Proto-Plastik/ULTIMATE/README.md

# Printers
Repository for Proto-Plastik ULTIMATE 3D printer.
This repository includes STL and STEP files.

Please refer to the PDF in this repository for detailed assembly drawings.
