Proto-Plastik/ULTIMATE/Power Supply Mount/A51Z Classic CLUB.xls

ITEM NO. | PART NUMBER | DESCRIPTION | QTY.
1 | A51Z Frame |  | 1
 | A5 Frame Drive Housing 1Z Z-Axis |  | 1
 | B18.3.1M - 3 x 0.5 x 12 Hex SHCS -- 12NHX |  | 12
 | B18.3.1M - 3 x 0.5 x 8 Hex SHCS -- 8NHX | SHCS M3x8 | 4
 | B18.3.1M - 3 x 0.5 x 16 Hex SHCS -- 16NHX |  | 2
 | B18.3.1M - 3 x 0.5 x 5 Hex SHCS -- 5NHX |  | 4
 | B18.3.1M - 8 x 1.25 x 25 Hex SHCS -- 25NHX |  | 1
 | 1Z z-axis drive housing-body |  | 1
 | 1Z z-axis-drive housing-cover |  | 1
 | GT2_Pulley |  | 1
 | OpenBuilds Nema 17 SKU775 | NEMA17 Stepper Motor | 1
 | A5 Bearing Assy Y- Axis | Bearing assembly for y-axis linear rods | 1
 | bearing cover and tray |  | 1
 | LM8LUU Bearing |  | 1
 | rigid coupler |  | 1
 | RAMPS Mount-front |  | 1
 | RAMPS Mount-rear |  | 1
 | RAMPS1_4 |  | 1
 | RAMPS1_4 |  | 1
 | User Library-POWER MOSFET, NON- SURFACE-MOUNT |  | 3
 | female_header_a- bl254-dg-g08d |  | 1
 | female_header_a- bl254-eg-g08d |  | 10
 | pin_header_aw254-dg -g36d |  | 1
 | pin_header_aw140-eg -g18d |  | 1
 | pin_header_aw140-eg -g08d |  | 5
 | pin_header_aw140-eg -g06d |  | 5
 | pin_header_aw140-eg -g04d |  | 6
 | pin_header_aw254-dg -g06d |  | 5
 | pin_header_aw254-dg -g08d |  | 3
 | pin_header_aw254-dg -g10d |  | 1
 | terminal_blocks_a- tb500-to06 |  | 1
 | terminal_blocks_a- tb508-oq04ch |  | 1
 | pin_header_aw140-eg -g02d |  | 1
 | pin_header_aw140-eg -g03d |  | 1
 | ARDUINO_MEGA |  | 1
 | ARDUINO_MEGA_BRD |  | 1
 | pin_header_aw140- eg-g02d |  | 3
 | User Library- Arduino Mega_DC POWER JACK |  | 1
 | User Library- Arduino Mega_USB SM host |  | 1
 | User Library- Arduino Mega_Atmega1280 (WGL) |  | 1
 | User Library- Arduino Mega_tactile BUTTON |  | 1
 | User Library- Arduino Mega_SM LED |  | 1
 | User Library- Arduino Mega_PIN HEADER FEMALE 2X18SLDPRT |  | 1
 | User Library- Arduino Mega_PIN HEADER FEMALE 6 |  | 1
 | User Library- Arduino Mega_PIN HEADER FEMALE 8 |  | 5
 | pin_header_aw254- dg-g06d |  | 1
 | User Library- CAPSMD6_3x3_9 |  | 6
 | User Library- CAPSMD6_3x3_9_CAP 003 |  | 1
 | User Library- CAPSMD6_3x3_9_CAP |  | 1
 | User Library- CAPSMD6_3x3_9_CAP 001 |  | 1
 | User Library- CAPSMD6_3x3_9_CAP 002 |  | 1
 | User Library- CAPSMD6_3x3_9_CAP 004 |  | 1
 | User Library- CAPSMD4x3_9 |  | 3
 | User Library- CAPSMD4x3_9_CAPSM D4x3_9003 |  | 1
 | User Library- CAPSMD4x3_9_CAPSM D4x3_9004 |  | 1
 | User Library- CAPSMD4x3_9_CAPSM D4x3_9002 |  | 1
 | User Library- CAPSMD4x3_9_CAPSM D4x3_9001 |  | 1
 | User Library- CAPSMD4x3_9_CAPSM D4x3_9 |  | 1
 | User Library- APA3010GCCK_GREE N |  | 1
 | User Library- APA3010GCCK_RED |  | 3
 | User Library-MF- R1100___ _________ |  | 1
 | User Library-MF- R500___ _________ |  | 1
 | User Library- SWITCH, TACTILE, RIGHT ANGLE, 12VDC, 50MA, 6_85MM ACTUATOR, WEALTH METAL TC-0244Z |  | 1
 | mounting foot TPE |  | 2
 | A5 Frame Chassis Center |  | 1
 | chassis |  | 1
 | 5mm ID x 8mm OD x 6mm Flanged |  | 2
 | R6RS bearing | - | 2
 | SBHCSCREW 0.3125- 18x1-HX-N |  | 2
 | GT2 Drive Pulley |  | 1
 | driveshaft |  | 1
 | B18.3.1M - 3 x 0.5 x 8 Hex SHCS -- 8NHX | SHCS M3x8 | 4
 | Part2^A5 Frame Chassis Center |  | 1
 | A5 Frame Drive Housing 1Z Y-Axis |  | 1
 | 1Z y-axis-drive housing-body |  | 1
 | A5 Bearing Assy Y- Axis | Bearing assembly for y-axis linear rods | 1
 | bearing cover and tray |  | 1
 | LM8LUU Bearing |  | 1
 | OpenBuilds Nema 17 SKU775 | NEMA17 Stepper Motor | 1
 | 1Z y-axis-drive housing-cover |  | 1
 | mounting foot TPE |  | 2
 | B18.3.1M - 3 x 0.5 x 12 Hex SHCS -- 12NHX |  | 12
 | B18.3.1M - 3 x 0.5 x 5 Hex SHCS -- 5NHX |  | 4
 | base gusset |  | 2
 | B18.3.1M - 3 x 0.5 x 16 Hex SHCS -- 16NHX |  | 4
 | B18.3.1M - 3 x 0.5 x 10 Hex SHCS -- 10NHX |  | 8
 | RDOM8 8mm rod | 8mm rod with 4mm threads in each end | 2
 | .375-12 x 12 Leadscrew |  | 1
2 | A51Z X-Axis Gantry |  | 1
 | A51Z X-Axis Gantry- left |  | 1
 | A51Z X-Gantry Left |  | 1
 | acme threaded retainer |  | 1
 | B18.3.1M - 3 x 0.5 x 16 Hex SHCS -- 16NHX |  | 6
 | B18.2.4.1M - Hex nut, Style 1, M3 x 0.5 --D-N |  | 2
 | A51Z X-Gantry Left- retainer |  | 1
 | B18.3.1M - 3 x 0.5 x 12 Hex SHCS -- 12NHX |  | 2
 | OpenBuilds Nema 17 SKU775 | NEMA17 Stepper Motor | 1
 | ProtoPlastik X-gantry spacer |  | 2
 | GT2 Drive Pulley |  | 1
 | LM8LUU Bearing |  | 1
 | A51Z X-Gantry-snap plug |  | 2
 | A51Z X-Axis Gantry- right |  | 1
 | LM8LUU Bearing |  | 1
 | A51Z X-Gantry Left- retainer |  | 1
 | B18.3.1M - 3 x 0.5 x 12 Hex SHCS -- 12NHX |  | 2
 | ProtoPlastik X-gantry spacer |  | 2
 | R6RS bearing | - | 2
 | A51Z X-Gantry Right |  | 1
 | A51Z X-Gantry Right- axle |  | 1
 | ProtoPlastik X-gantry RIGHT-cap |  | 1
 | A51Z X-Gantry Right- tensioner |  | 1
 | A51Z X-Gantry Right- tightening knob | Tightening Knob | 1
 | A51Z X-Gantry Right- lock nut | Locking Nut | 1
 | A51Z X-Gantry-snap plug |  | 2
 | RDOM8 8mm rod |  | 2
 | x-drive belt |  | 1
 | Filament Drive |  | 1
 | OpenBuilds Nema 17 SKU775 | NEMA17 Stepper Motor | 1
 | MK7 | MK7 Filament Drive Gear | 1
 | e3D Lite6 | e3D Lite6 1.75 | 1
 | parte_sotto_lite6 |  | 1
 | corpo_lite6 |  | 1
 | 30x10 fan |  | 1
 | Fan Shroud |  | 1
 | B18.3.4M - 3 x 0.5 x 10 SBHCS --N |  | 2
 | B18.3.1M - 3 x 0.5 x 16 Hex SHCS -- 16NHX |  | 4
 | B18.3.1M - 3 x 0.5 x 35 Hex SHCS -- 18NHX | SHCS M3x35 | 3
 | B18.3.1M - 3 x 0.5 x 16 Hex SHCS -- 16NHX |  | 9
 | B18.3.1M - 3 x 0.5 x 5 Hex SHCS -- 5NHX |  | 1
 | hot end mount- body |  | 1
 | hot end cover | Direct Drive Outer Bracket | 1
 | filament guide access |  | 1
 | motor mount | Motor Mount | 1
 | hot end retainer | Hot End Retainer | 1
 | Filament Drive Tightener | Direct Drive Tightener | 1
 | tensioner | Body | 1
 | 624zz |  | 1
 | B18.3.1M - 3 x 0.5 x 16 Hex SHCS -- 16NHX |  | 1
 | lock nut | Locking Nut | 1
 | tightening knob | Tightening Knob | 1
 | Filament Drive Bearing Holder | Drive Bearing Holder | 1
 | LM8LUU Bearing |  | 2
 | B18.3.1M - 3 x 0.5 x 16 Hex SHCS -- 16NHX |  | 2
 | B18.3.1M - 3 x 0.5 x 12 Hex SHCS -- 12NHX |  | 2
 | bearing holder body | BODY | 1
 | bearing lower retainer | LOWER RETAINER | 1
 | bearing upper retainer | UPPER RETAINER | 1
 | belt retainer | Belt Retainer | 1
 | ptfe tube |  | 1
3 | A51Z Truss |  | 1
 | B18.3.1M - 3 x 0.5 x 20 Hex SHCS -- 20NHX |  | 4
 | B18.3.1M - 3 x 0.5 x 10 Hex SHCS -- 10NHX |  | 6
 | B18.3.1M - 4 x 0.7 x 20 Hex SHCS -- 20NHX |  | 4
 | B18.3.1M - 8 x 1.25 x 30 Hex SHCS -- 30NHX |  | 2
 | B18.3.1M - 4 x 0.7 x 8 Hex SHCS -- 8NHX |  | 1
 | B18.3.1M - 3 x 0.5 x 12 Hex SHCS -- 12NHX |  | 1
 | truss handle bottom |  | 1
 | truss handle top |  | 1
 | truss left |  | 1
 | truss right |  | 1
 | truss right-retainer |  | 1
 | truss left-retainer |  | 1
 | truss center |  | 1
 | GT2_Pulley |  | 2
 | Anti-sag belt |  | 1
 | filament guide |  | 1
4 | A5 Bed |  | 1
 | B18.3.1M - 3 x 0.5 x 16 Hex SHCS -- 16NHX |  | 4
 | B18.3.1M - 3 x 0.5 x 12 Hex SHCS -- 12NHX |  | 4
 | glass clip |  | 4
 | 8 x 8.5 glass |  | 1
 | A5 Bed Build Platform | Modular, printable build platform. | 1
 | build platform-NE |  | 1
 | build platform-NW |  | 1
 | build platform-SE |  | 1
 | build platform-SW |  | 1
 | glass support |  | 2
 | straight spring |  | 4
 | spring cup |  | 8
 | glass support-OH |  | 2
 | B18.22M - Plain washer, 3 mm, narrow |  | 4
 | B18.3.1M - 3 x 0.5 x 35 Hex SHCS -- 18NHX | SHCS M3x35 | 4
 | B18.3.1M - 3 x 0.5 x 25 Hex SHCS -- 18NHX |  | 6
 | B18.3.1M - 3 x 0.5 x 16 Hex SHCS -- 16NHX |  | 4
 | B18.3.1M - 3 x 0.5 x 10 Hex SHCS -- 10NHX |  | 4
 | build platform-clip retainer-OH |  | 2
 | build platform-clip retainer |  | 2
 | A5 Bed Chassis | Modular 3D printable bed chassis | 1
 | bed chassis- spreader |  | 1
 | bed chassis-shaft retainer |  | 4
 | bed chassis- spreader-OH |  | 1
 | bed chassis-belt retainer |  | 2
 | B18.3.1M - 3 x 0.5 x 20 Hex SHCS -- 20NHX |  | 8
 | B18.3.1M - 3 x 0.5 x 12 Hex SHCS -- 12NHX |  | 4
 | RDOM8 8mm rod |  | 2
 | B18.2.4.2M - Hex nut, Style 2, M3 x 0.5 --D-N |  | 8
 | silicon standoff |  | 4
 | heated-bed-glass |  | 1
 | B18.3.1M - 3 x 0.5 x 10 Hex SHCS -- 10NHX |  | 2
5 | B18.3.1M - 3 x 0.5 x 16 Hex SHCS -- 16NHX |  | 11
6 | B18.3.1M - 4 x 0.7 x 12 Hex SHCS -- 12NHX |  | 1
7 | B18.3.1M - 4 x 0.7 x 10 Hex SHCS -- 10NHX |  | 2
