Proto-Plastik/ULTIMATE/2Z X-Axis Bearing Holder - LEFT/STEP/stepper (hardware)-dampener.STEP

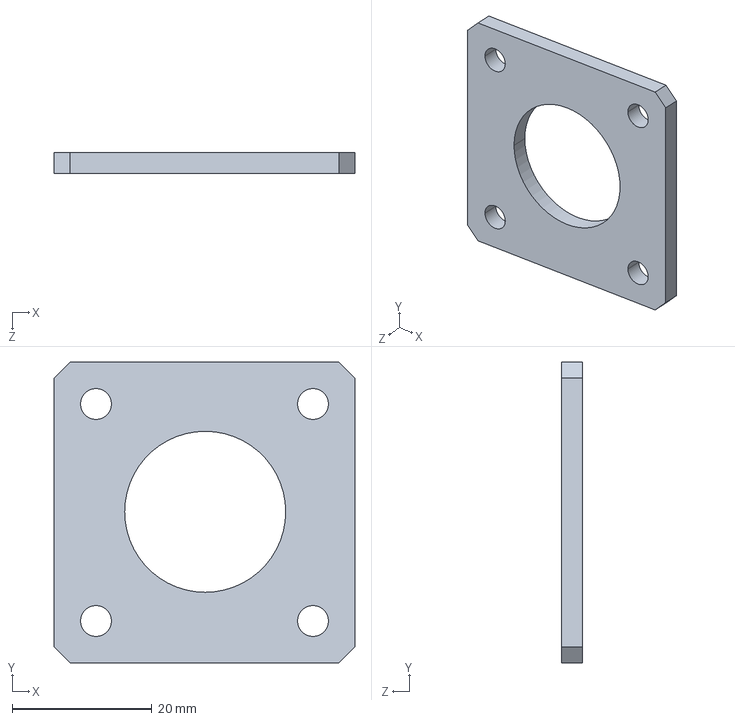
[picture p1: CAD file, 2019-01-01]
2Z X-Axis Bearing Holder - LEFT/STEP/stepper (hardware)-dampener.STEP
43.0 x 43.0 x 3.00 mm
