Proto-Plastik/ULTIMATE/2Z X-Axis Bearing Holder - RIGHT/bearing axle.STL

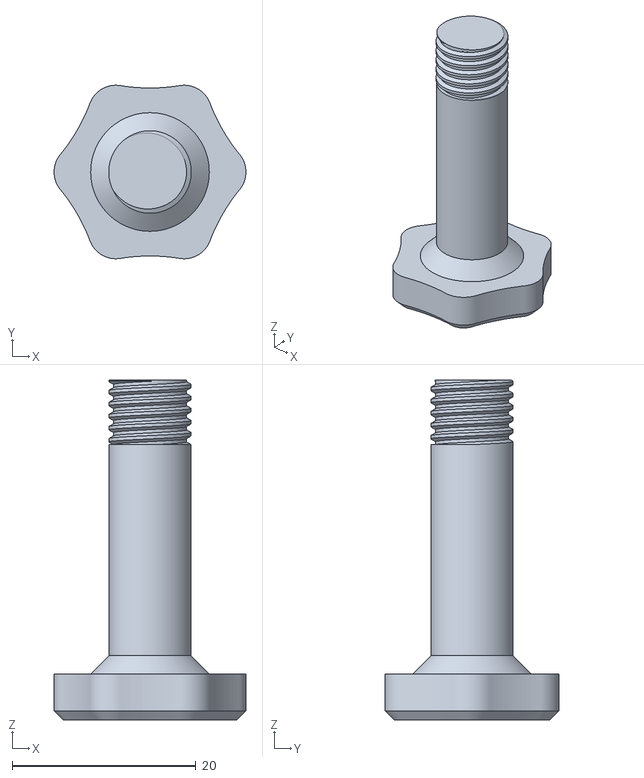
[picture p2: CAD file, 2017-12-21]
2Z X-Axis Bearing Holder - RIGHT/bearing axle.STL
20.9 x 18.9 x 37.0
