Proto-Plastik/ULTIMATE/2Z X-Axis Bearing Holder - RIGHT/STEP/2Z bearing holder right cover.STEP

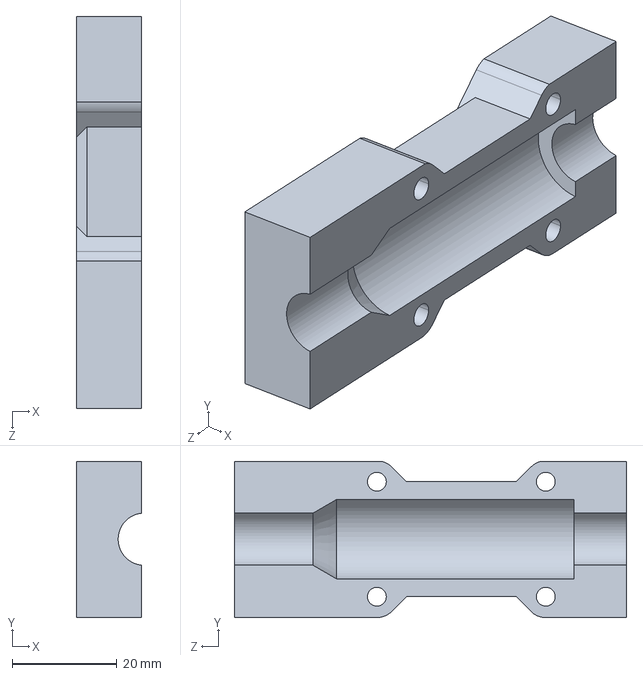
[picture p3: CAD file, 2019-01-01]
2Z X-Axis Bearing Holder - RIGHT/STEP/2Z bearing holder right cover.STEP
12.5 x 29.9 x 75.0 mm
