Proto-Plastik/ULTIMATE/A5 Bed Chassis/STEP/bed chassis-end stop.STEP

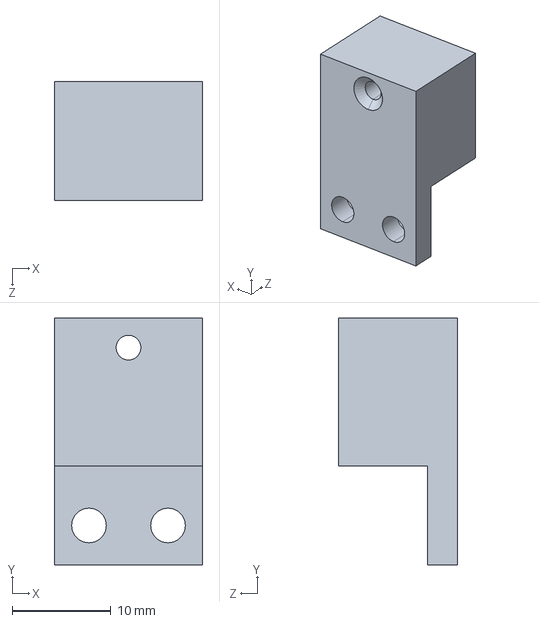
[picture p5: CAD file, 2019-01-01]
A5 Bed Chassis/STEP/bed chassis-end stop.STEP
15.0 x 25.0 x 12.0 mm
