Proto-Plastik/ULTIMATE/A5 Bed/STEP/build platform-clip retainer-OH.STEP

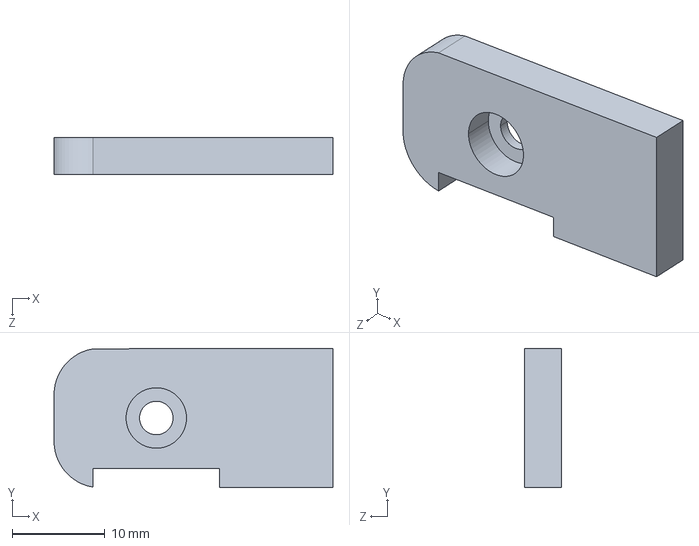
[picture p6: CAD file, 2019-01-01]
A5 Bed/STEP/build platform-clip retainer-OH.STEP
30.0 x 15.0 x 4.00 mm
