Proto-Plastik/ULTIMATE/A5 Frame Chassis Center/STEP/5mm ID x 8mm OD x 6mm Flanged.STEP

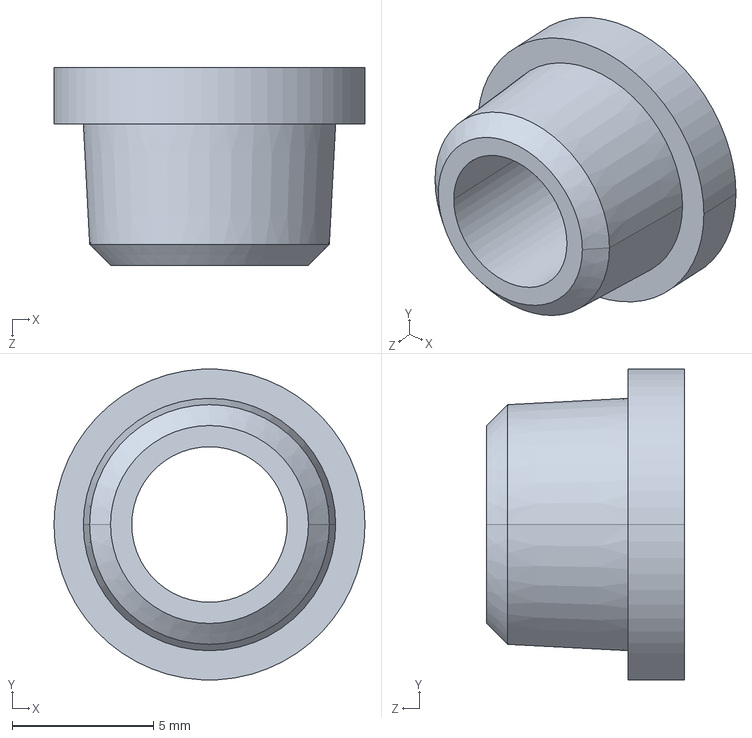
[picture p7: CAD file, 2019-01-01]
A5 Frame Chassis Center/STEP/5mm ID x 8mm OD x 6mm Flanged.STEP
11.0 x 11.0 x 7.00 mm
