Proto-Plastik/ULTIMATE/Controller Enclosure/STEP/display mount-rear cover.STEP

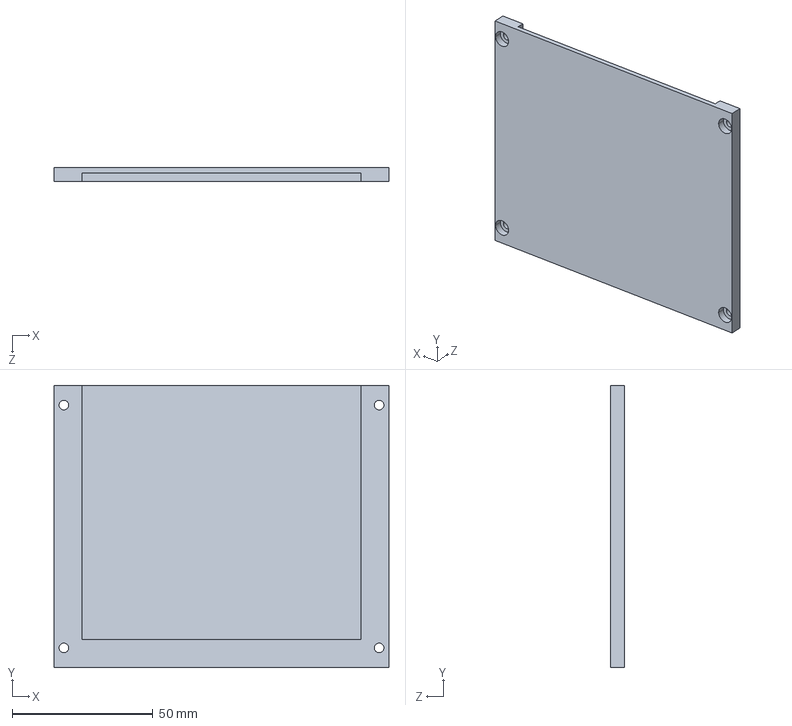
[picture p8: CAD file, 2019-01-01]
Controller Enclosure/STEP/display mount-rear cover.STEP
119.0 x 100.3 x 5.00 mm
