Proto-Plastik/ULTIMATE/Electronics Base/STEP/electronics base.STEP

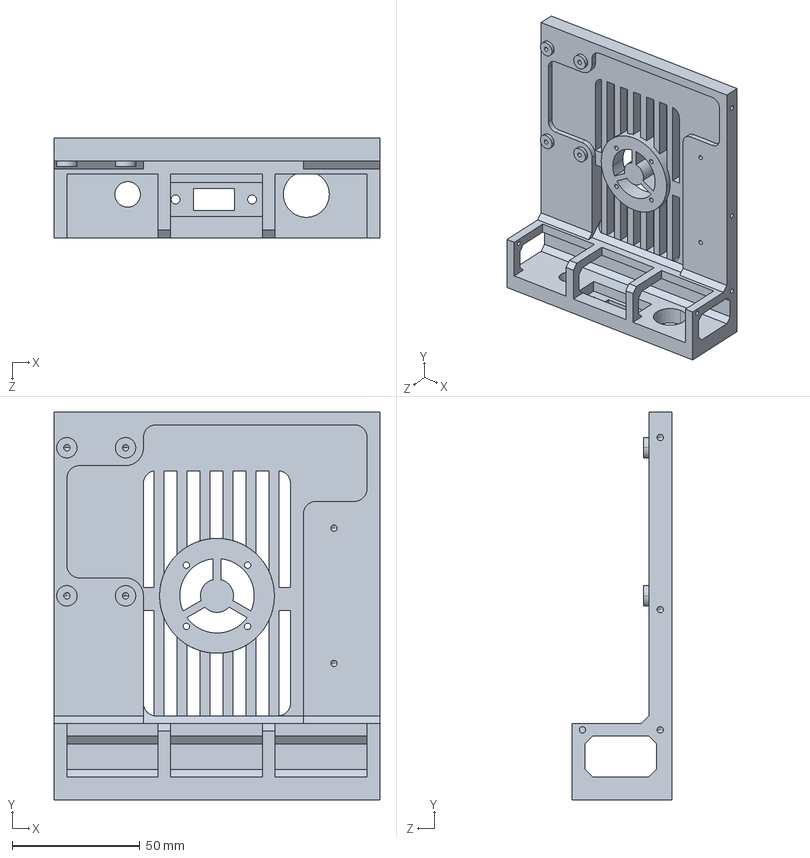
[picture p9: CAD file, 2019-01-01]
Electronics Base/STEP/electronics base.STEP
127.6 x 152.0 x 39.0 mm
