Proto-Plastik/ULTIMATE/Filament Drive Bearing Holder/STEP/bearing upper retainer (LM8LUU).STEP

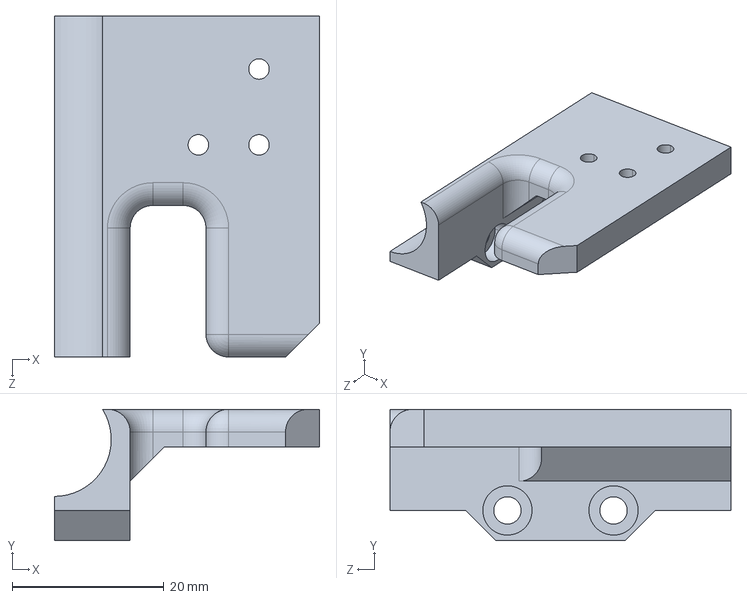
[picture p10: CAD file, 2019-01-01]
Filament Drive Bearing Holder/STEP/bearing upper retainer (LM8LUU).STEP
35.0 x 17.4 x 45.0 mm
