Proto-Plastik/ULTIMATE/Filament Drive Bed Leveling/STEP/Filament Drive BL Touch Mount.STEP

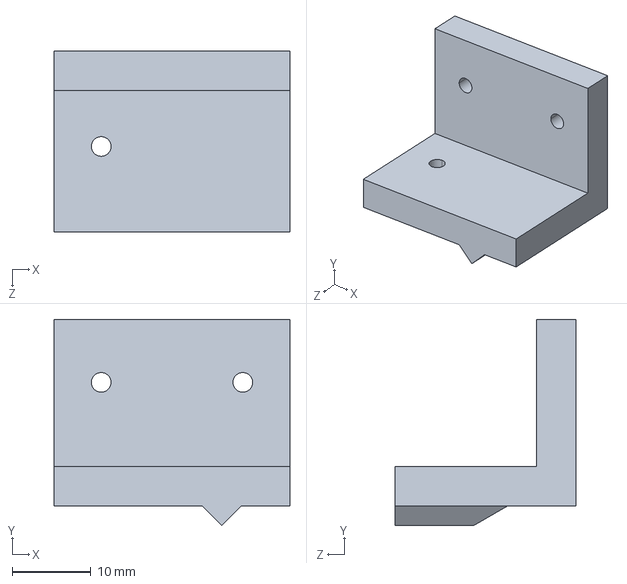
[picture p11: CAD file, 2019-01-01]
Filament Drive Bed Leveling/STEP/Filament Drive BL Touch Mount.STEP
30.0 x 26.2 x 23.0 mm
