Proto-Plastik/ULTIMATE/Filament Drive Cooling Fan/STEP/nozzle bracket.STEP

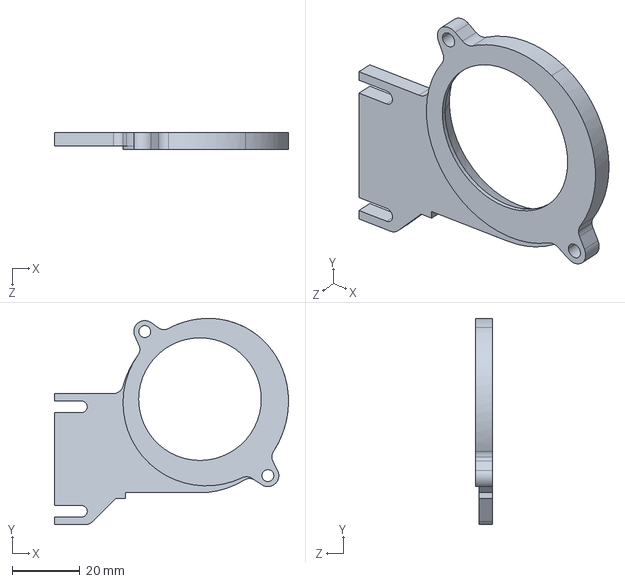
[picture p12: CAD file, 2019-01-01]
Filament Drive Cooling Fan/STEP/nozzle bracket.STEP
69.2 x 61.0 x 5.00 mm
