Proto-Plastik/ULTIMATE/Filament Drive Tightener/STEP/tensioner.STEP

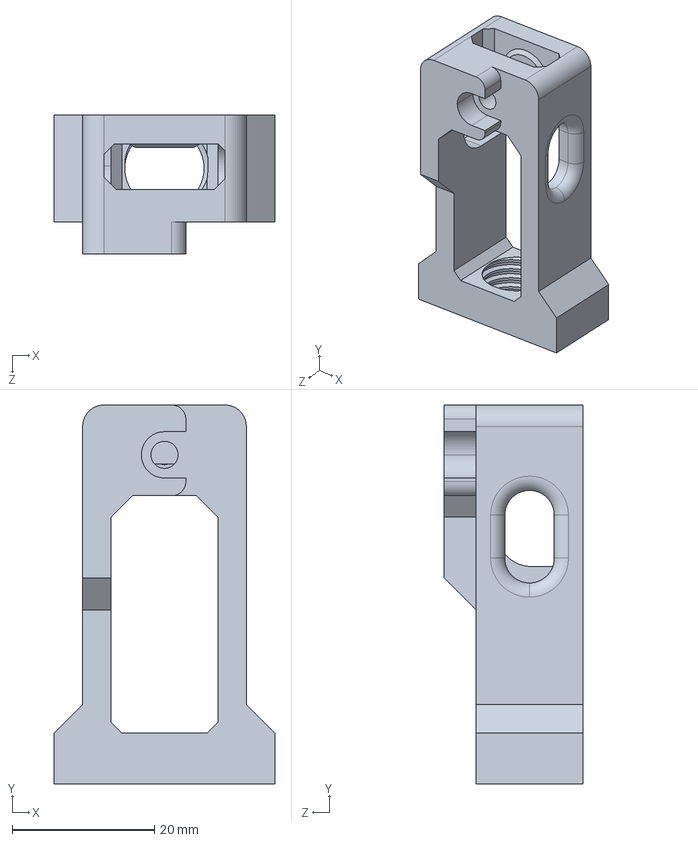
[picture p13: CAD file, 2019-01-01]
Filament Drive Tightener/STEP/tensioner.STEP
31.0 x 53.2 x 19.5 mm
