Proto-Plastik/ULTIMATE/Filament Spool Holder/STEP/filament spool holder spindle-shaft 2Z OH (OH).STEP

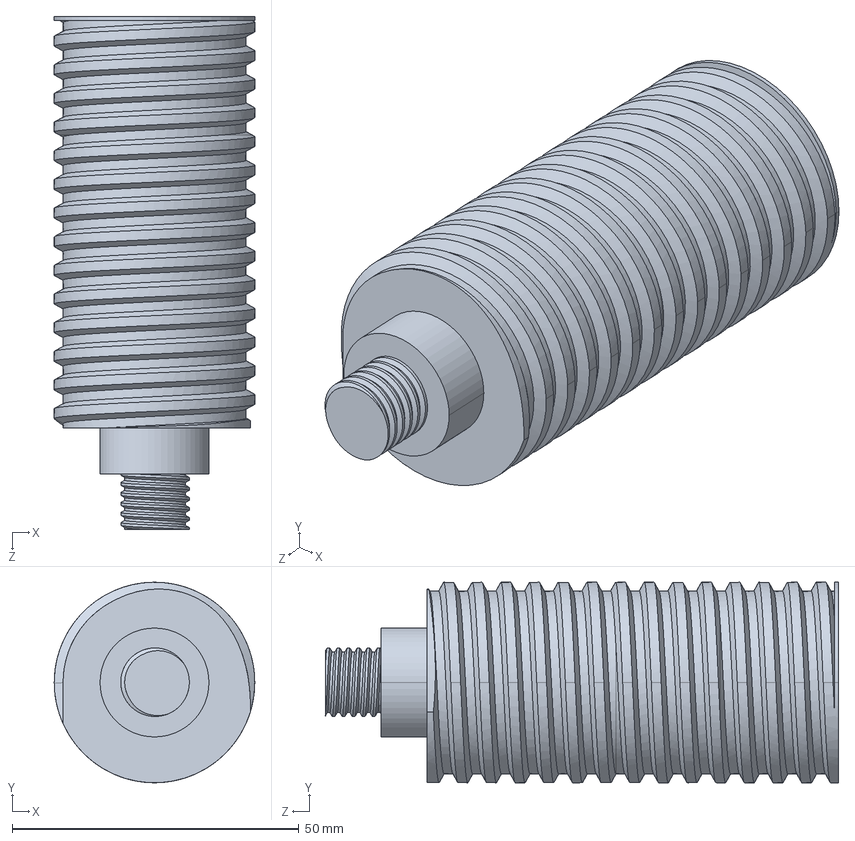
[picture p14: CAD file, 2019-01-01]
Filament Spool Holder/STEP/filament spool holder spindle-shaft 2Z OH (OH).STEP
35.0 x 35.0 x 89.5 mm
