Proto-Plastik/ULTIMATE/Motor Houisng YZ-Axis/STEP/rigid coupler.STEP

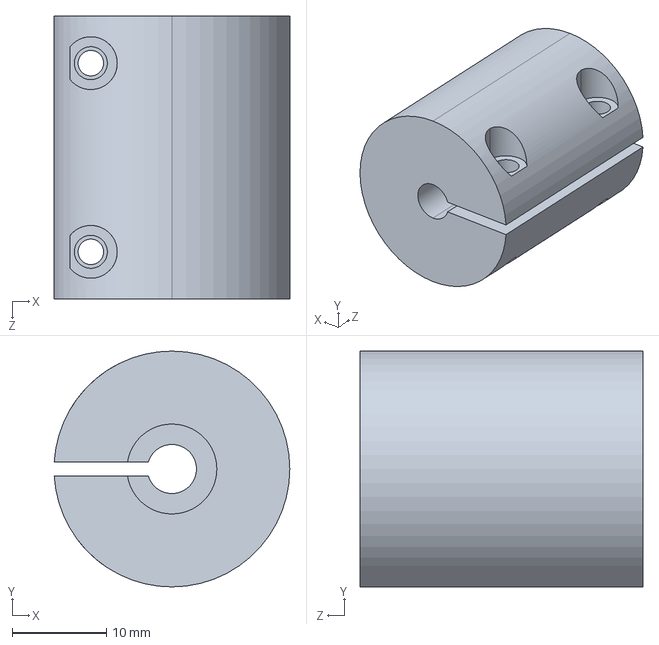
[picture p15: CAD file, 2019-01-01]
Motor Houisng YZ-Axis/STEP/rigid coupler.STEP
25.0 x 25.0 x 30.0 mm
