Proto-Plastik/ULTIMATE/Motor Housing Z-Axis/STEP/motor housing LEFT-Body.STEP

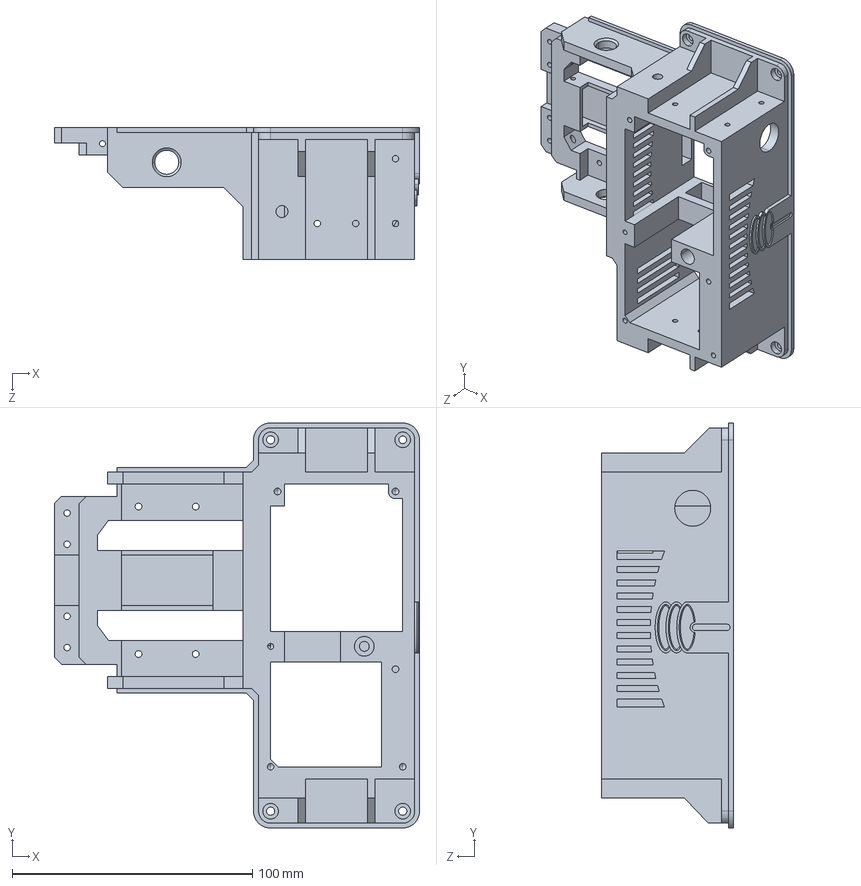
[picture p16: CAD file, 2019-01-01]
Motor Housing Z-Axis/STEP/motor housing LEFT-Body.STEP
152.0 x 168.6 x 55.0 mm
