Proto-Plastik/ULTIMATE/Name Bar/Name Bar-banner.STL

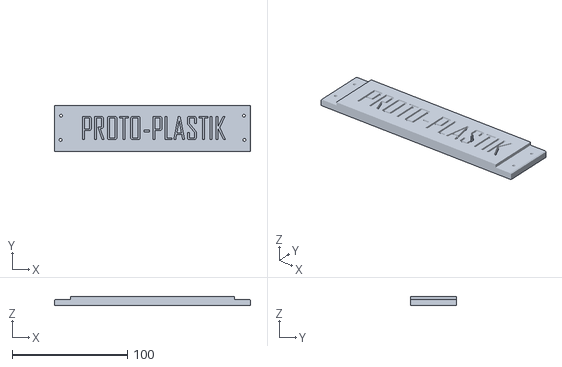
[picture p17: CAD file, 2017-12-31]
Name Bar/Name Bar-banner.STL
170.0 x 40.0 x 7.50
