Proto-Plastik/ULTIMATE/Name Bar/STEP/Name Bar-end.STEP

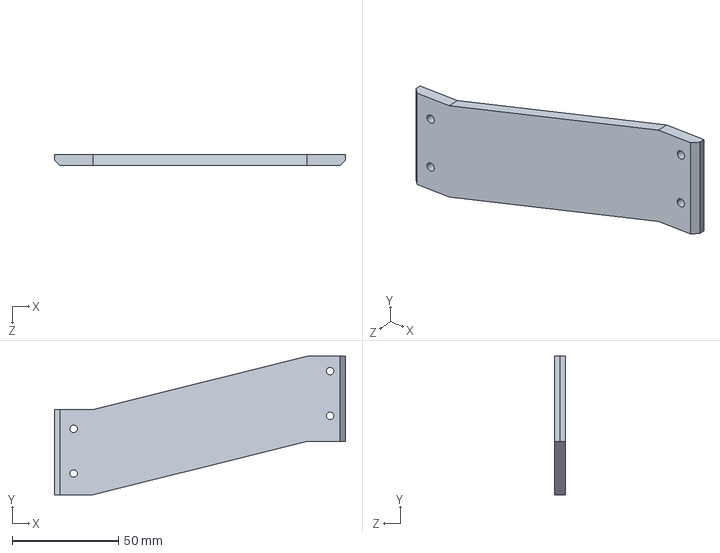
[picture p18: CAD file, 2019-01-01]
Name Bar/STEP/Name Bar-end.STEP
136.7 x 65.1 x 5.00 mm
