Proto-Plastik/ULTIMATE/PI Camera Housing/STEP/PI_CAMERA-cover.STEP

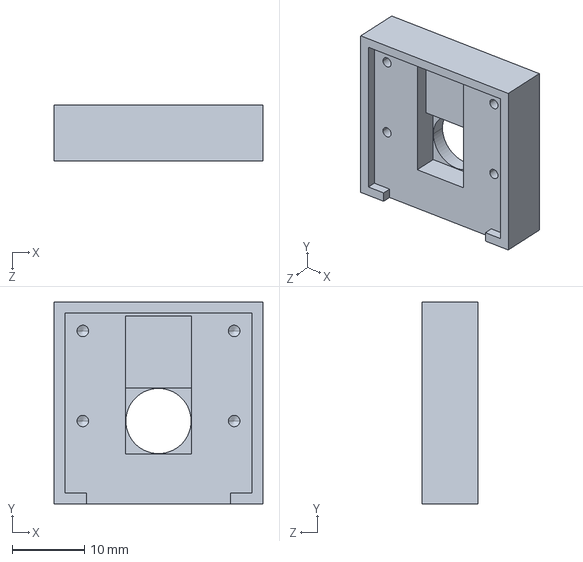
[picture p19: CAD file, 2019-01-01]
PI Camera Housing/STEP/PI_CAMERA-cover.STEP
29.0 x 28.0 x 7.80 mm
