Proto-Plastik/ULTIMATE/Power Supply Mount/STEP/lower cross brace (ULTIMATE).STEP

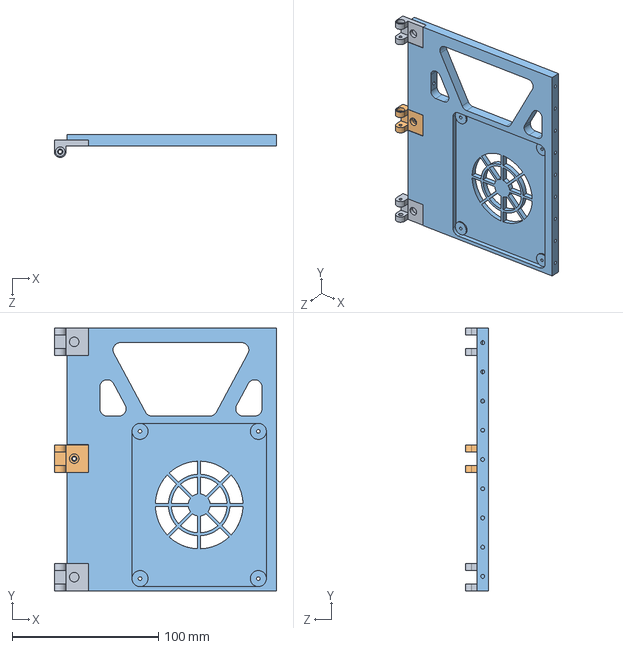
[picture p20: CAD file, 2019-01-01]
Power Supply Mount/STEP/lower cross brace (ULTIMATE).STEP
152.1 x 180.0 x 15.8 mm
