Proto-Plastik/ULTIMATE/Spool Mount Truss/STEP/spool holder bracket - front (Spool Holder).STEP

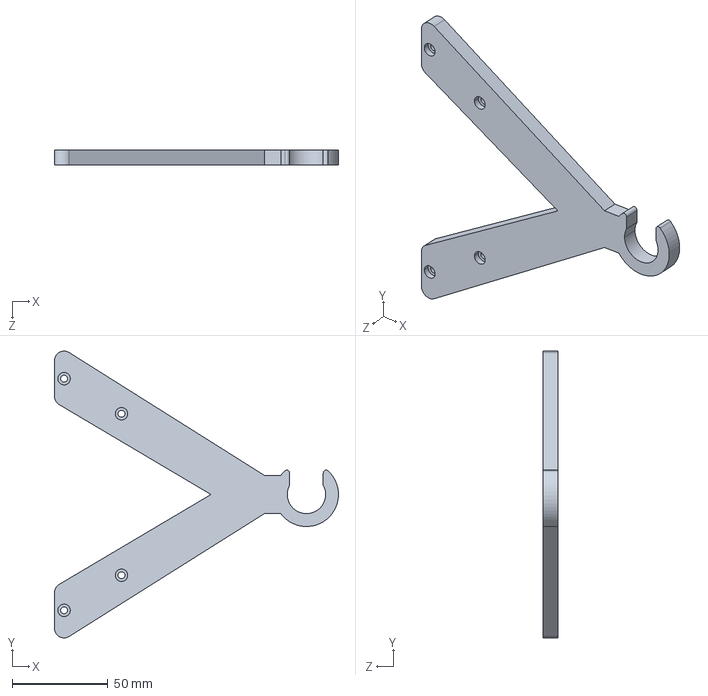
[picture p21: CAD file, 2019-01-01]
Spool Mount Truss/STEP/spool holder bracket - front (Spool Holder).STEP
148.3 x 149.8 x 8.00 mm
