Proto-Plastik/ULTIMATE/Truss Handle/STEP/truss handle top.STEP

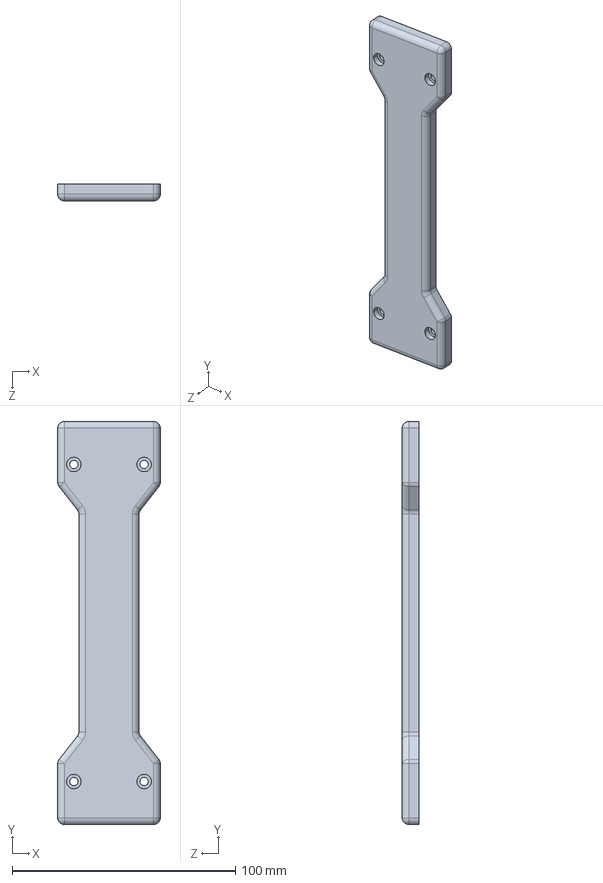
[picture p22: CAD file, 2019-01-01]
Truss Handle/STEP/truss handle top.STEP
46.0 x 180.5 x 7.50 mm
