Proto-Plastik/ULTIMATE/Vertical Truss-left with Electronics Enclosure/STEP/vertical truss-left front upper.STEP

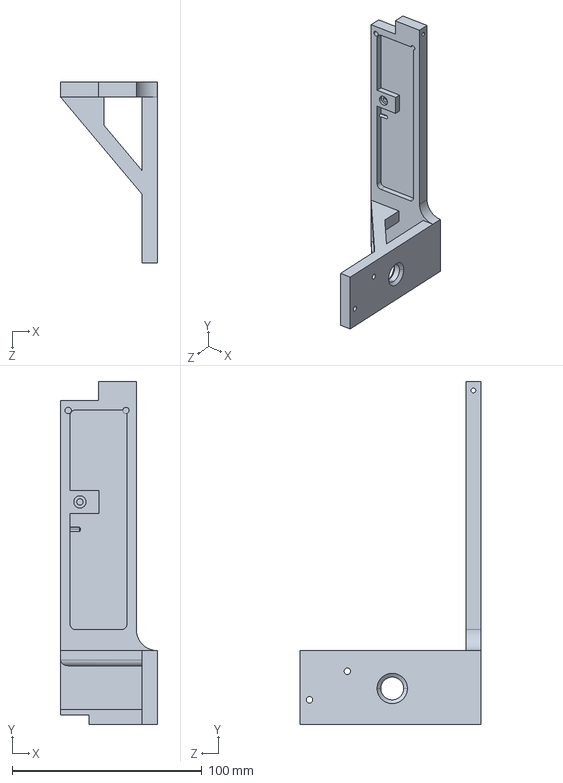
[picture p23: CAD file, 2019-01-01]
Vertical Truss-left with Electronics Enclosure/STEP/vertical truss-left front upper.STEP
51.1 x 181.0 x 95.5 mm
