Proto-Plastik/ULTIMATE/Vertical Truss-right with Spool Mount/STEP/vertical truss-right rear upper.STEP

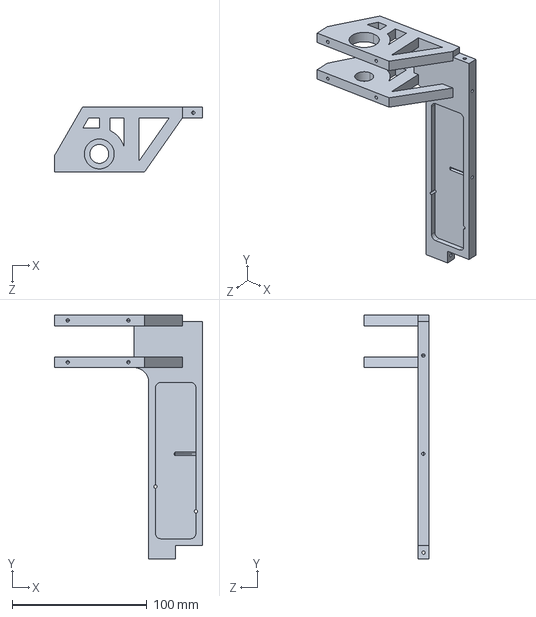
[picture p24: CAD file, 2019-01-01]
Vertical Truss-right with Spool Mount/STEP/vertical truss-right rear upper.STEP
110.0 x 181.0 x 48.1 mm
