Proto-Plastik/ULTIMATE/Y-Axis Bearing Cover and Tray/STEP/Cover and Tray.STEP

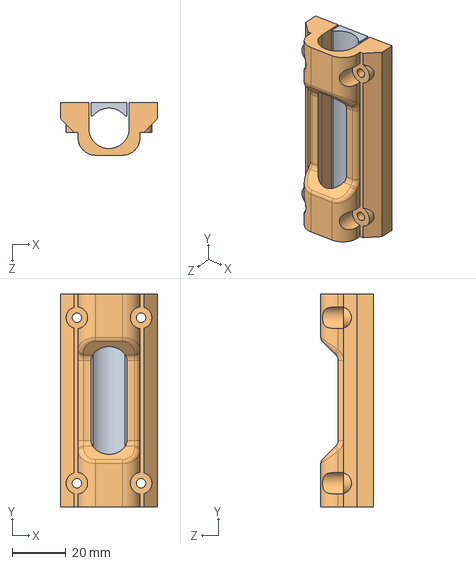
[picture p25: CAD file, 2019-01-01]
Y-Axis Bearing Cover and Tray/STEP/Cover and Tray.STEP
36.0 x 79.0 x 19.5 mm
