Proto-Plastik/ULTIMATE/2Z X-Axis Bearing Holder - LEFT/STEP/2Z bearing holder left cover.STEP

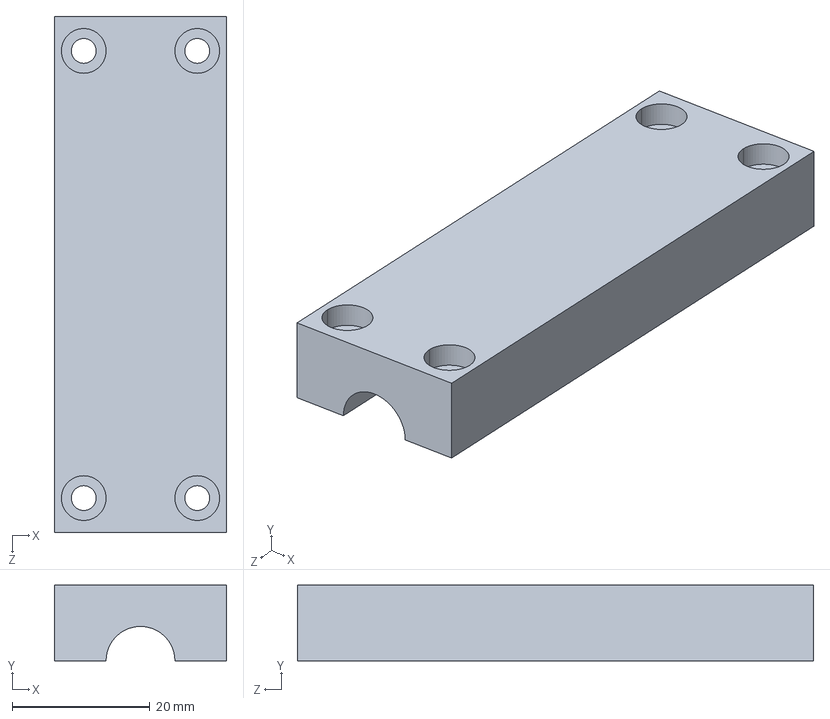
[picture p28: CAD file, 2019-01-01]
2Z X-Axis Bearing Holder - LEFT/STEP/2Z bearing holder left cover.STEP
25.0 x 11.0 x 75.0 mm
