Proto-Plastik/ULTIMATE/2Z X-Axis Bearing Holder - RIGHT/STEP/tightening knob.STEP

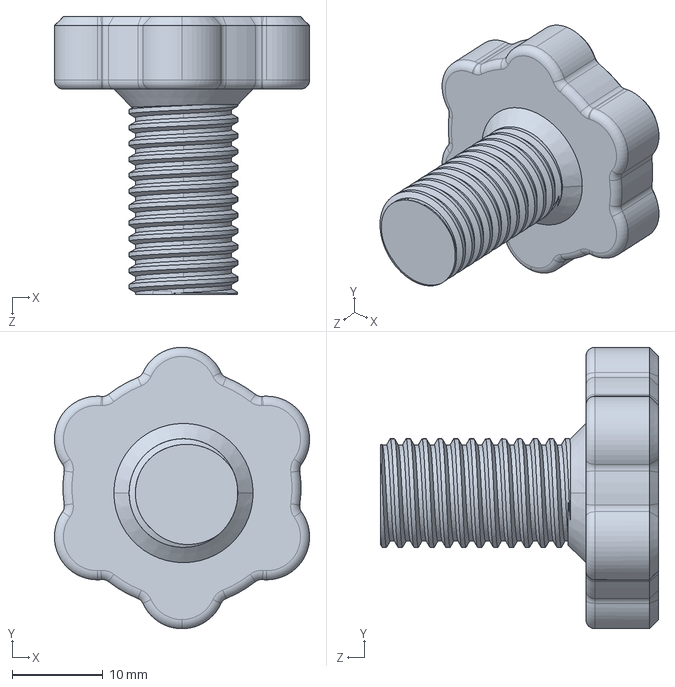
[picture p29: CAD file, 2019-01-01]
2Z X-Axis Bearing Holder - RIGHT/STEP/tightening knob.STEP
28.1 x 31.0 x 30.6 mm
