Proto-Plastik/ULTIMATE/A5 Bed Build Platform/STEP/build platform-SE.STEP

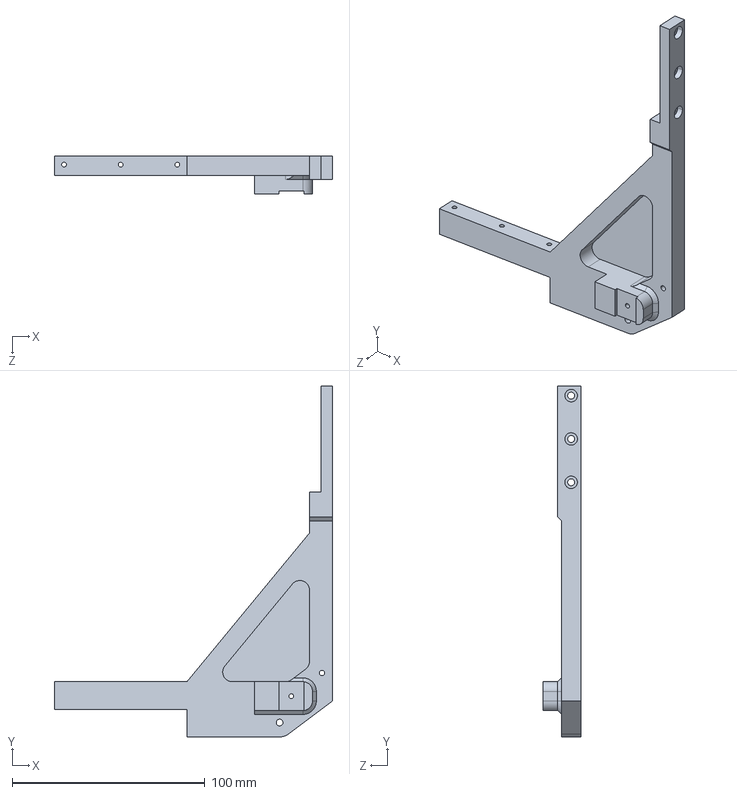
[picture p30: CAD file, 2019-01-01]
A5 Bed Build Platform/STEP/build platform-SE.STEP
144.4 x 182.2 x 19.5 mm
