Proto-Plastik/ULTIMATE/A5 Frame Chassis Center/STEP/chassis (300mm).STEP

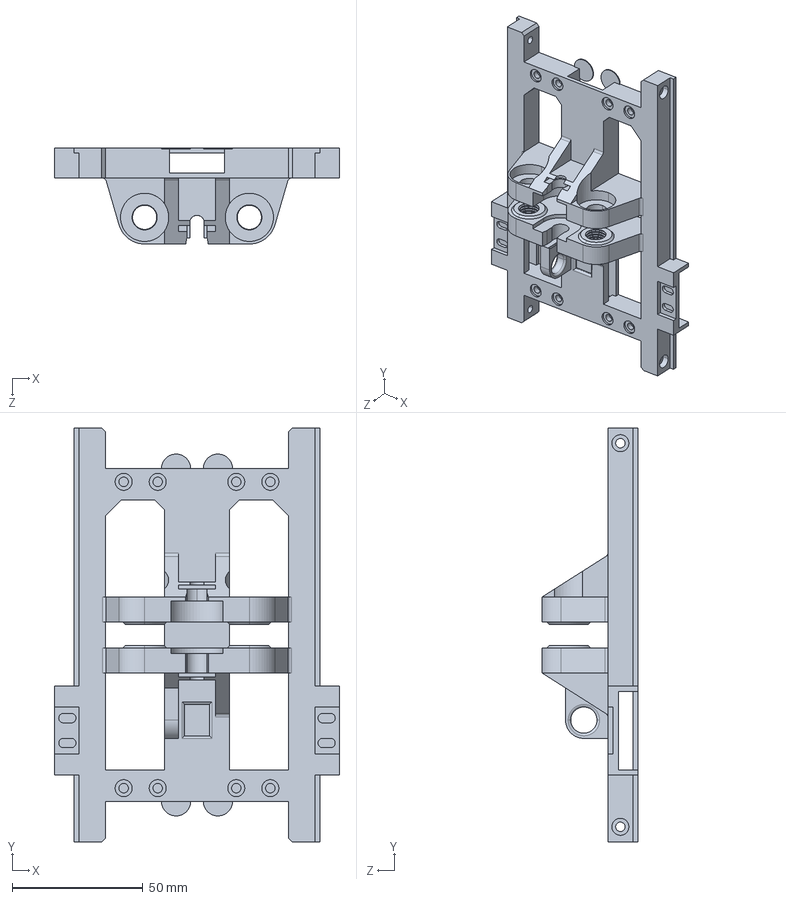
[picture p32: CAD file, 2019-01-01]
A5 Frame Chassis Center/STEP/chassis (300mm).STEP
109.0 x 158.1 x 36.7 mm
