Proto-Plastik/ULTIMATE/Controller Enclosure/STEP/display mount-cover.STEP

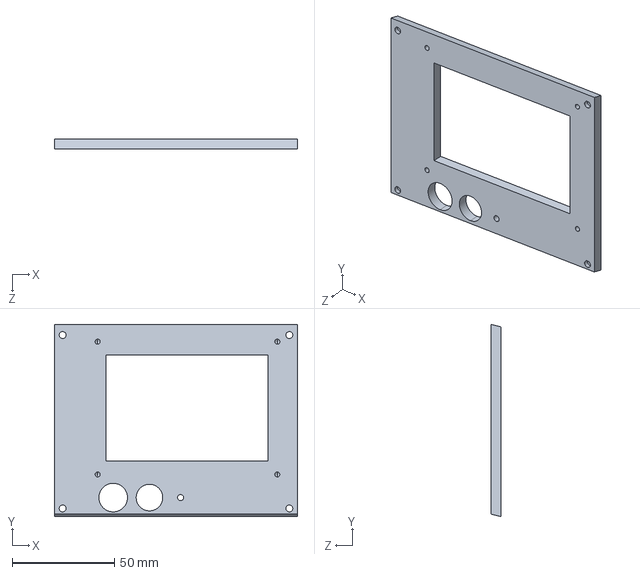
[picture p33: CAD file, 2019-01-01]
Controller Enclosure/STEP/display mount-cover.STEP
119.0 x 94.1 x 5.00 mm
