Proto-Plastik/ULTIMATE/Filament Drive Bearing Holder/STEP/bearing lower retainer (LM8LUU).STEP

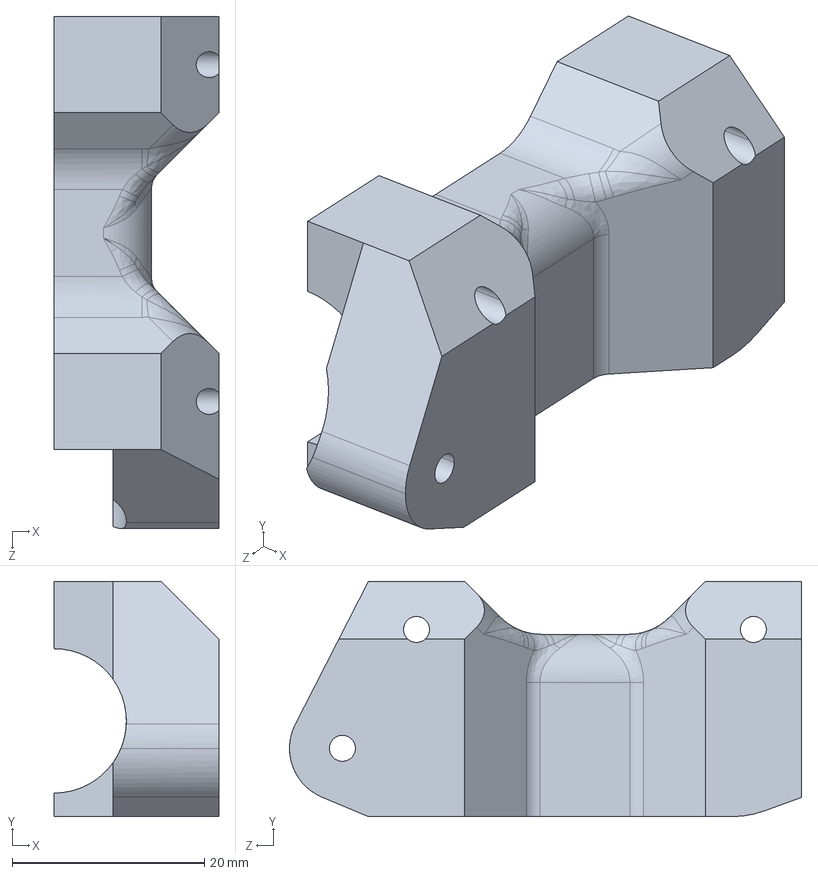
[picture p34: CAD file, 2019-01-01]
Filament Drive Bearing Holder/STEP/bearing lower retainer (LM8LUU).STEP
17.1 x 24.4 x 53.2 mm
