Proto-Plastik/ULTIMATE/Filament Drive Cooling Fan/STEP/fan nozzle (BL2).STEP

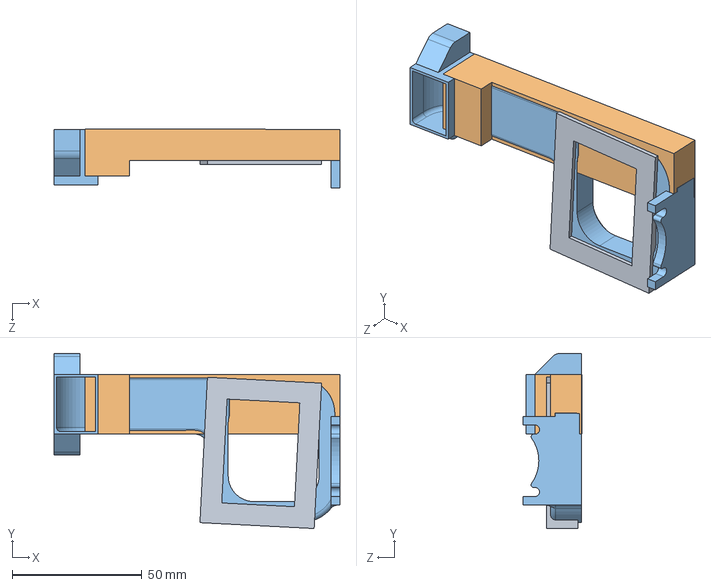
[picture p35: CAD file, 2019-01-01]
Filament Drive Cooling Fan/STEP/fan nozzle (BL2).STEP
110.0 x 67.3 x 22.7 mm
