Proto-Plastik/ULTIMATE/Filament Drive Tightener/STEP/tightening knob (filament drive).STEP

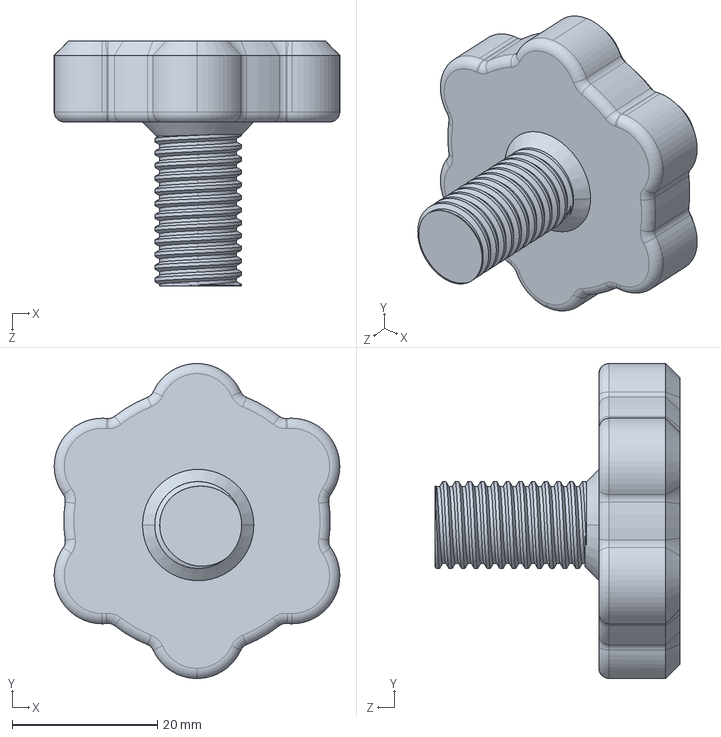
[picture p36: CAD file, 2019-01-01]
Filament Drive Tightener/STEP/tightening knob (filament drive).STEP
39.4 x 43.4 x 33.8 mm
