Proto-Plastik/ULTIMATE/Filament Drive/STEP/hot end retainer.STEP

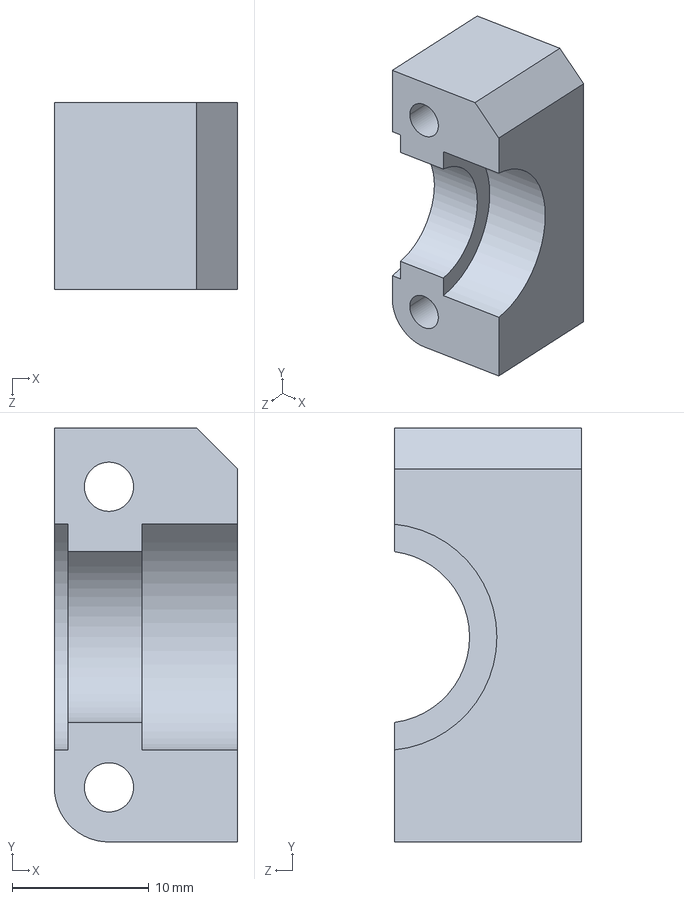
[picture p37: CAD file, 2019-01-01]
Filament Drive/STEP/hot end retainer.STEP
13.4 x 30.3 x 13.7 mm
