Proto-Plastik/ULTIMATE/Filament Spool Holder/STEP/filament spool holder spindle-retainer (OH).STEP

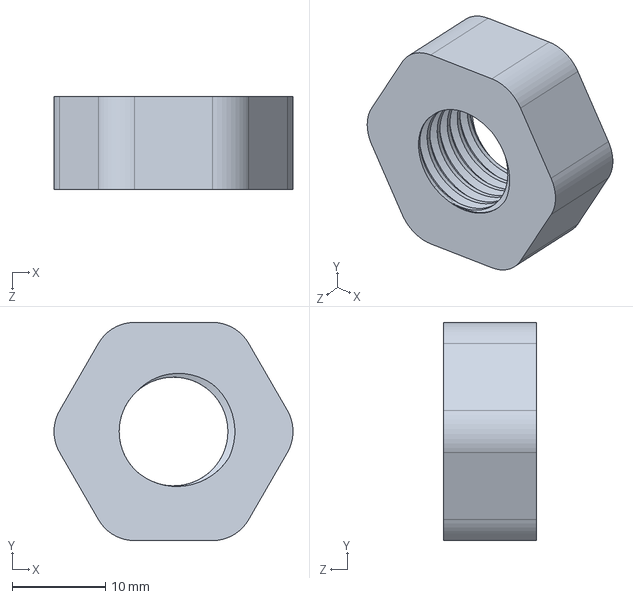
[picture p38: CAD file, 2019-01-01]
Filament Spool Holder/STEP/filament spool holder spindle-retainer (OH).STEP
25.6 x 23.4 x 10.0 mm
