Proto-Plastik/ULTIMATE/Motor Houisng YZ-Axis/STEP/mounting foot TPE.STEP

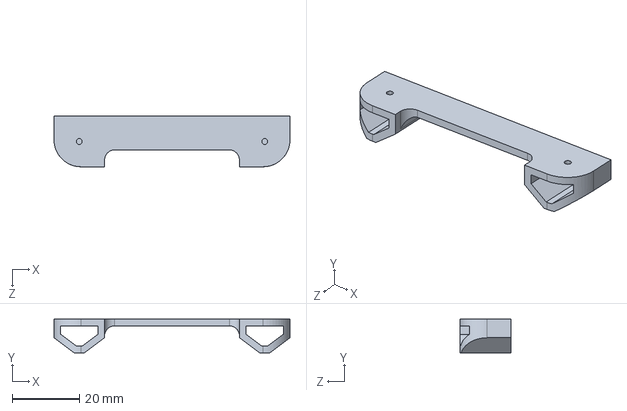
[picture p39: CAD file, 2019-01-01]
Motor Houisng YZ-Axis/STEP/mounting foot TPE.STEP
70.0 x 10.0 x 15.0 mm
