Proto-Plastik/ULTIMATE/Motor Housing Z-Axis/STEP/motor housing LEFT-Cover.STEP

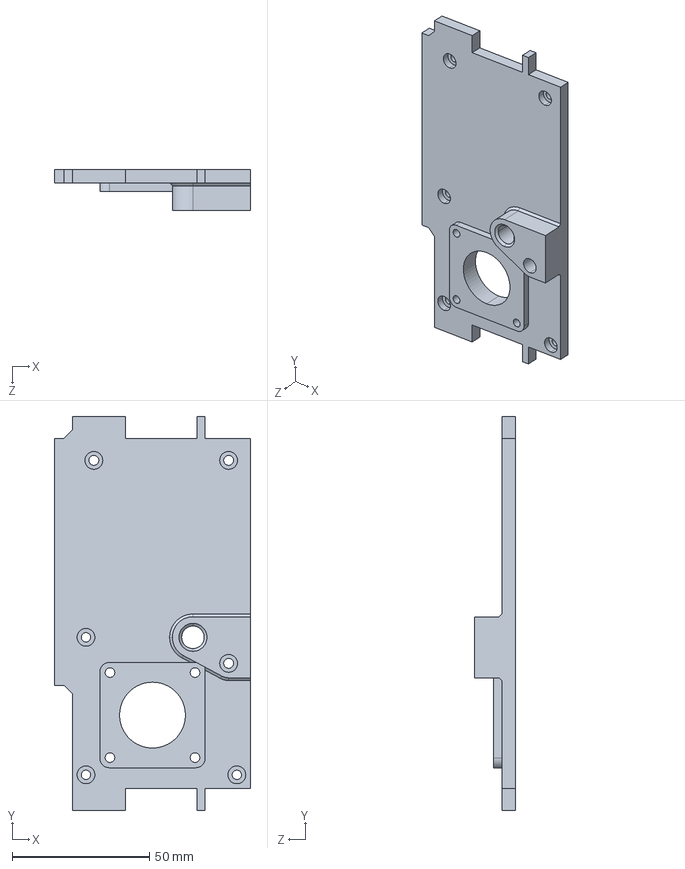
[picture p40: CAD file, 2019-01-01]
Motor Housing Z-Axis/STEP/motor housing LEFT-Cover.STEP
71.5 x 143.6 x 15.0 mm
