Proto-Plastik/ULTIMATE/PI Camera Housing/STEP/PI_CAMERA-body.STEP

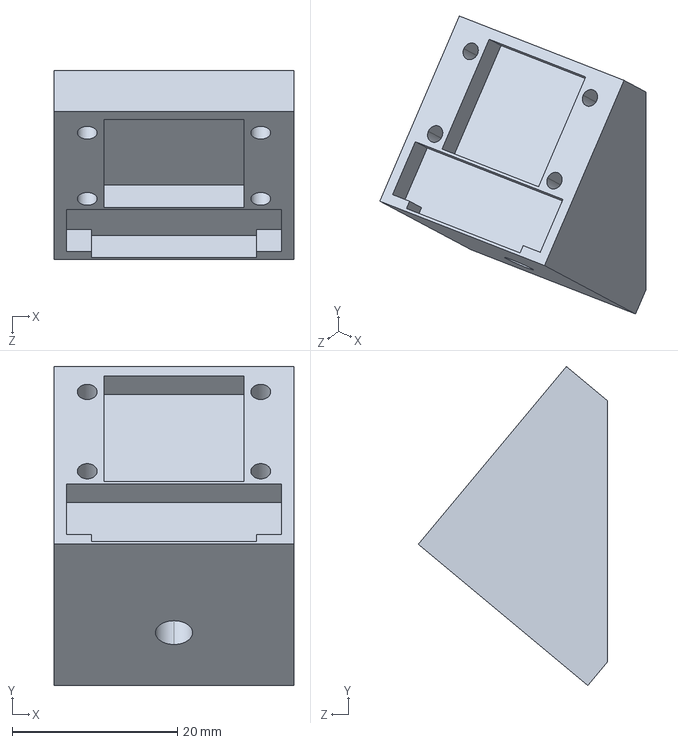
[picture p41: CAD file, 2019-01-01]
PI Camera Housing/STEP/PI_CAMERA-body.STEP
29.0 x 38.6 x 22.9 mm
