Proto-Plastik/ULTIMATE/Power Supply Mount/STEP/latch.STEP

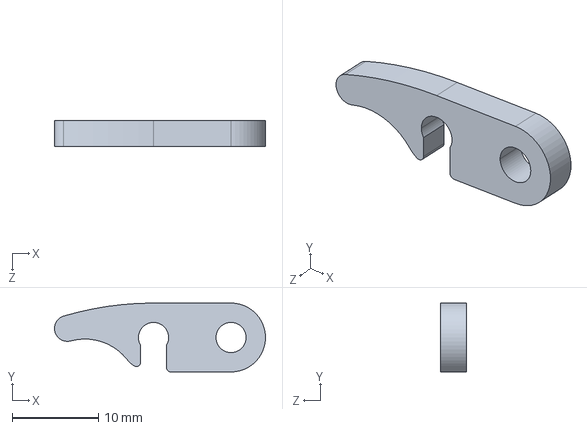
[picture p42: CAD file, 2019-01-01]
Power Supply Mount/STEP/latch.STEP
24.5 x 8.00 x 3.00 mm
