Proto-Plastik/ULTIMATE/Truss Handle/STEP/truss end (ULTIMATE).STEP

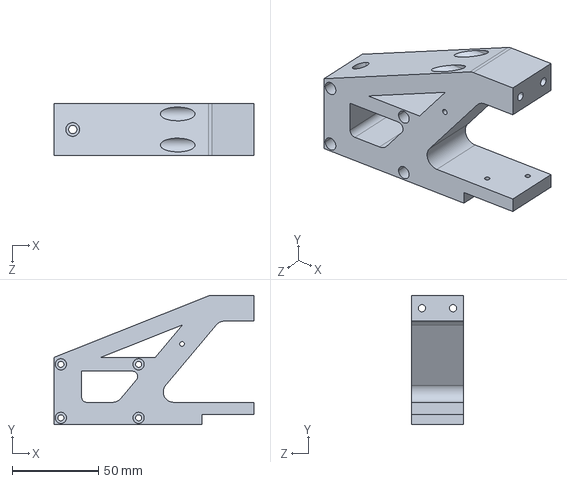
[picture p43: CAD file, 2019-01-01]
Truss Handle/STEP/truss end (ULTIMATE).STEP
115.8 x 75.0 x 30.0 mm
