Proto-Plastik/ULTIMATE/Vertical Truss-left with Electronics Enclosure/STEP/lower front-hinge.STEP

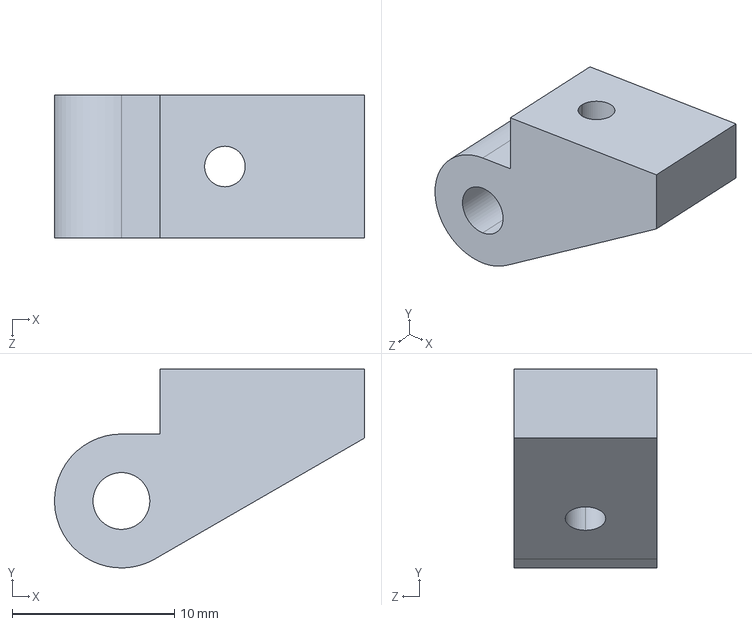
[picture p44: CAD file, 2019-01-01]
Vertical Truss-left with Electronics Enclosure/STEP/lower front-hinge.STEP
19.1 x 12.2 x 8.80 mm
