Proto-Plastik/ULTIMATE/Vertical Truss-right with Spool Mount/STEP/vertical truss -right rear lower.STEP

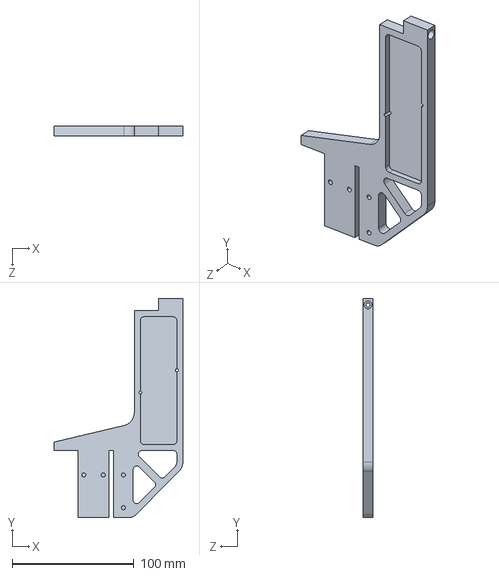
[picture p45: CAD file, 2019-01-01]
Vertical Truss-right with Spool Mount/STEP/vertical truss -right rear lower.STEP
105.9 x 180.0 x 8.00 mm
