Proto-Plastik/ULTIMATE/2Z X-Axis Bearing Holder - LEFT/STEP/2Z bearing holder left body (LM8LUU).STEP

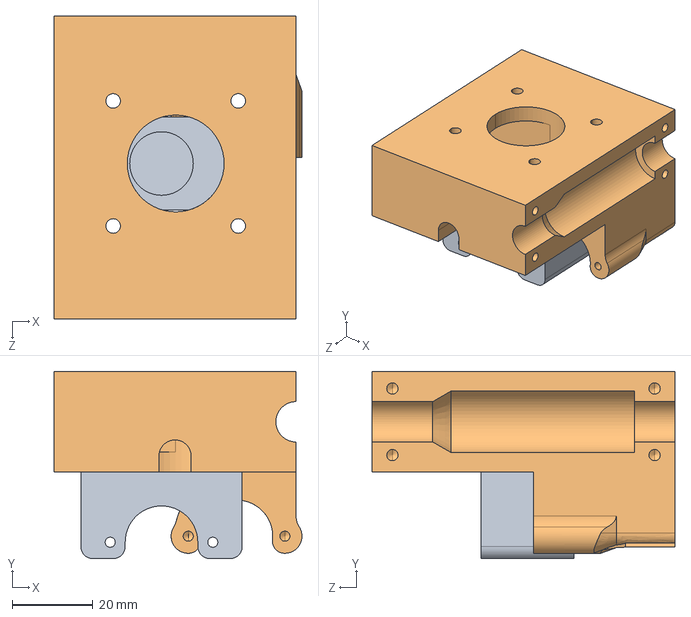
[picture p46: CAD file, 2019-01-01]
2Z X-Axis Bearing Holder - LEFT/STEP/2Z bearing holder left body (LM8LUU).STEP
61.5 x 46.4 x 75.0 mm
