Proto-Plastik/ULTIMATE/A5 Bed Chassis/STEP/bed chassis-shaft retainer.STEP

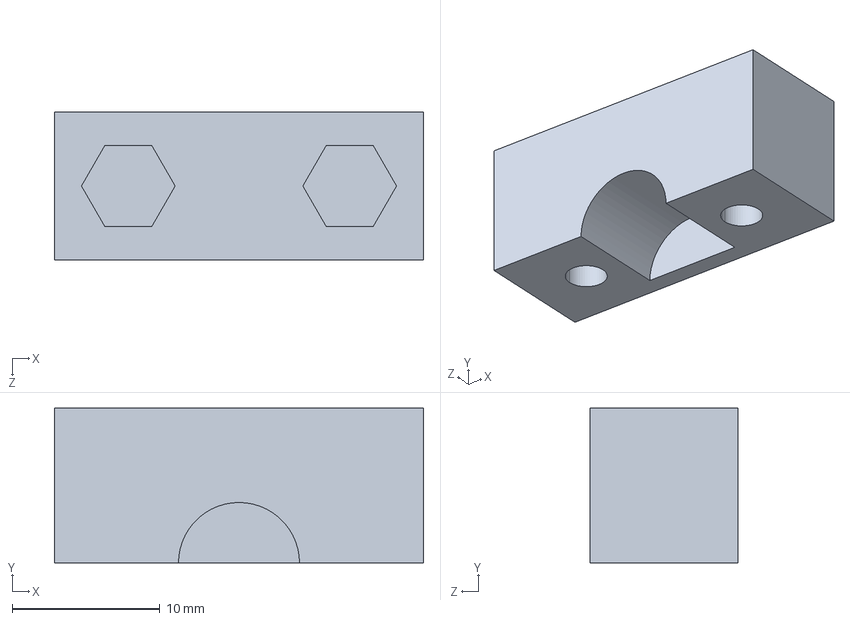
[picture p47: CAD file, 2019-01-01]
A5 Bed Chassis/STEP/bed chassis-shaft retainer.STEP
25.0 x 10.5 x 10.0 mm
