Proto-Plastik/ULTIMATE/Controller Enclosure/STEP/display mount-body.STEP

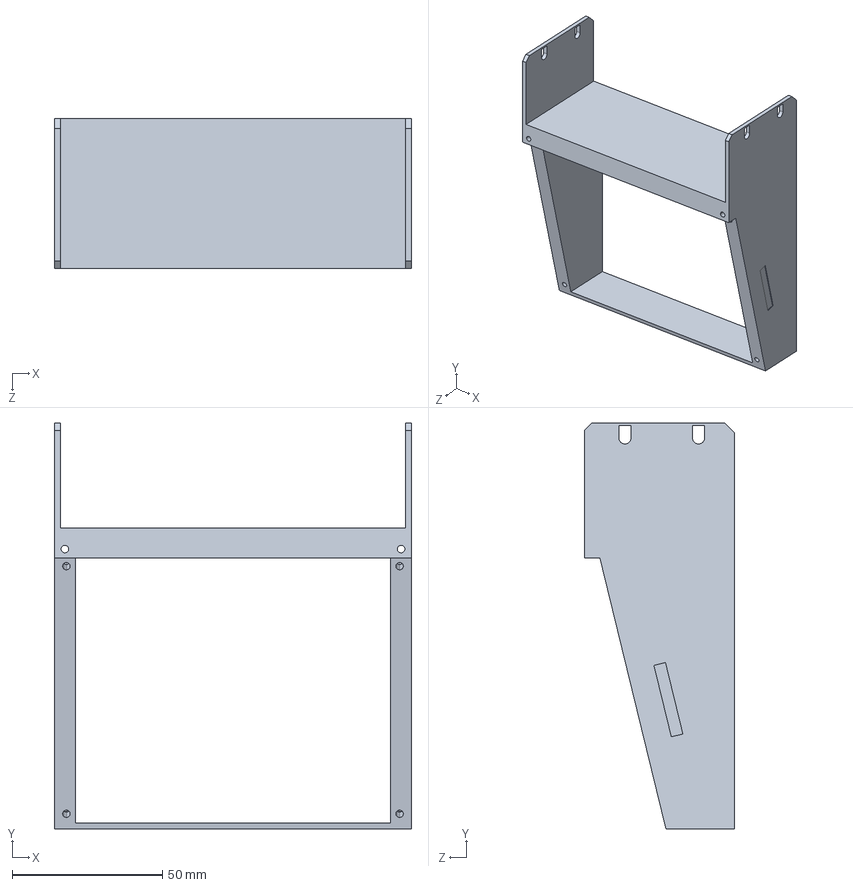
[picture p48: CAD file, 2019-01-01]
Controller Enclosure/STEP/display mount-body.STEP
119.0 x 135.3 x 50.0 mm
