Proto-Plastik/ULTIMATE/Filament Drive/STEP/motor mount.STEP

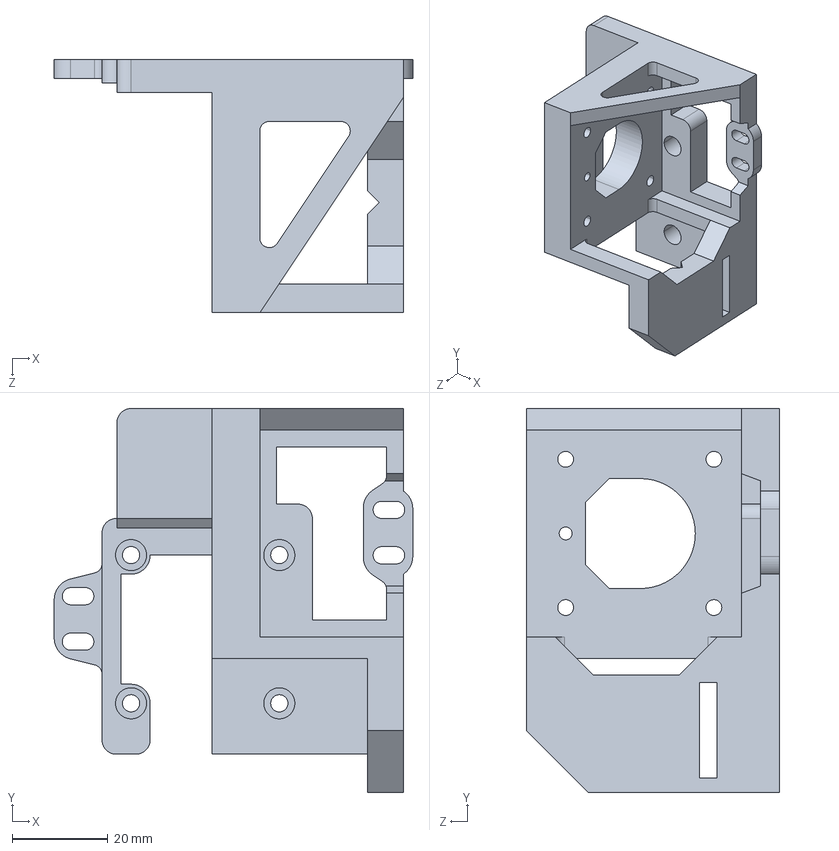
[picture p50: CAD file, 2019-01-01]
Filament Drive/STEP/motor mount.STEP
75.0 x 80.3 x 53.0 mm
