Proto-Plastik/ULTIMATE/Power Supply Mount/STEP/lower cross brace-cover hinge.STEP

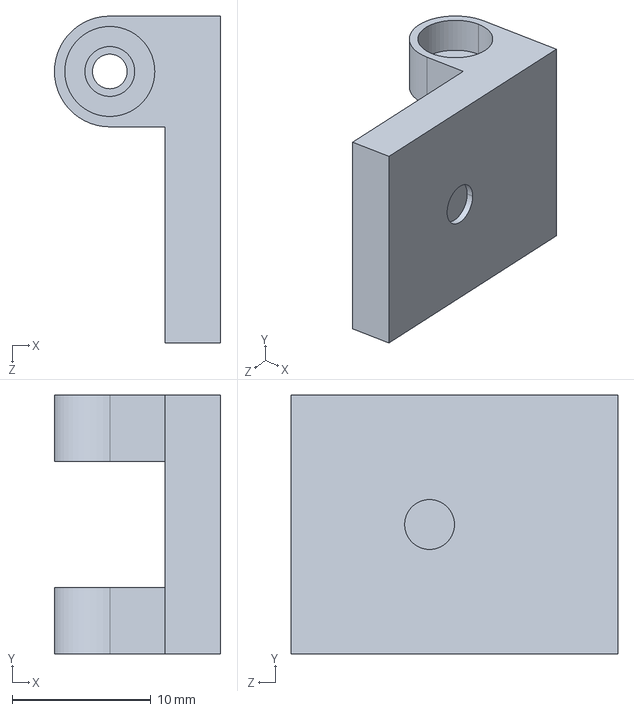
[picture p51: CAD file, 2019-01-01]
Power Supply Mount/STEP/lower cross brace-cover hinge.STEP
12.0 x 18.7 x 23.6 mm
