Proto-Plastik/ULTIMATE/Truss Handle/STEP/filament guide (single).STEP

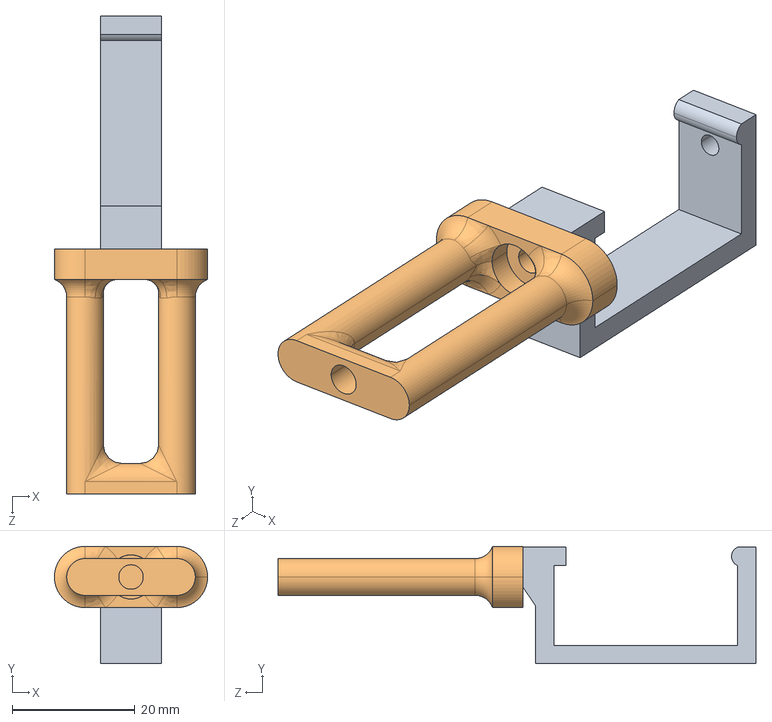
[picture p52: CAD file, 2019-01-01]
Truss Handle/STEP/filament guide (single).STEP
25.0 x 19.1 x 78.0 mm
