Proto-Plastik/ULTIMATE/Vertical Truss-left with Electronics Enclosure/STEP/vertical truss-left front lower.STEP

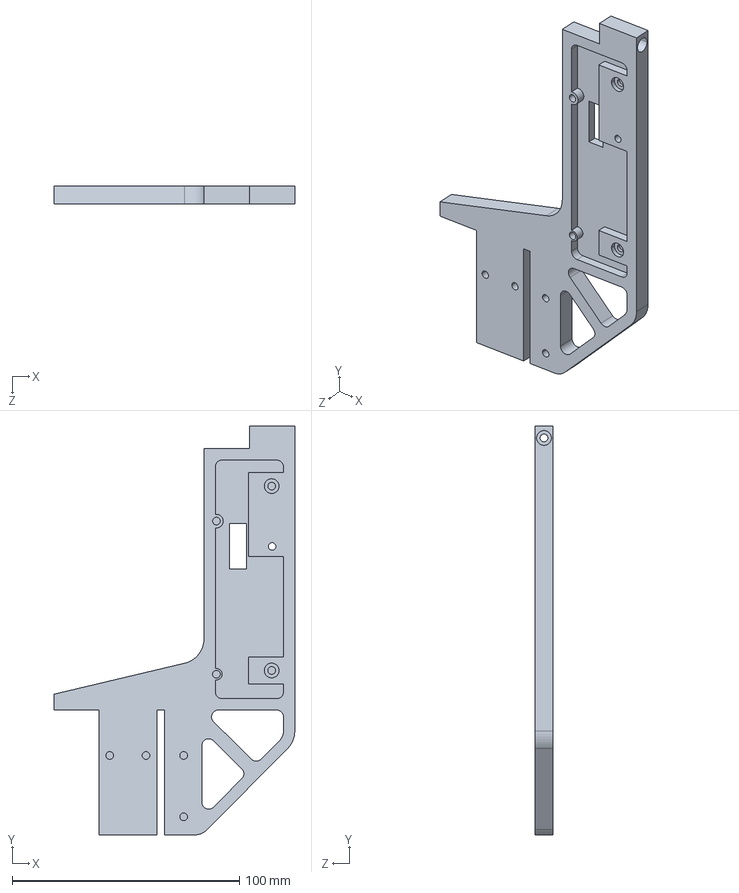
[picture p53: CAD file, 2019-01-01]
Vertical Truss-left with Electronics Enclosure/STEP/vertical truss-left front lower.STEP
105.9 x 180.0 x 8.00 mm
