Proto-Plastik/ULTIMATE/Vertical Truss-right with Spool Mount/STEP/top cross brace (with Filament Guide).STEP

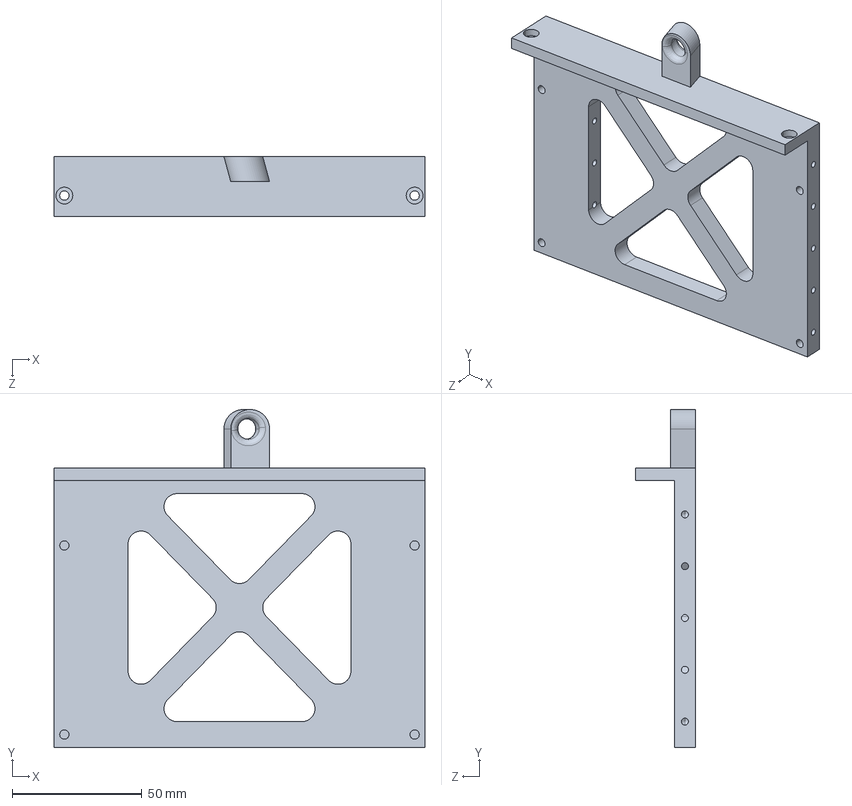
[picture p54: CAD file, 2019-01-01]
Vertical Truss-right with Spool Mount/STEP/top cross brace (with Filament Guide).STEP
143.2 x 130.5 x 23.0 mm
