Proto-Plastik/ULTIMATE/2Z X-Axis Bearing Holder - RIGHT/STEP/2Z bearing holder right body-body.STEP

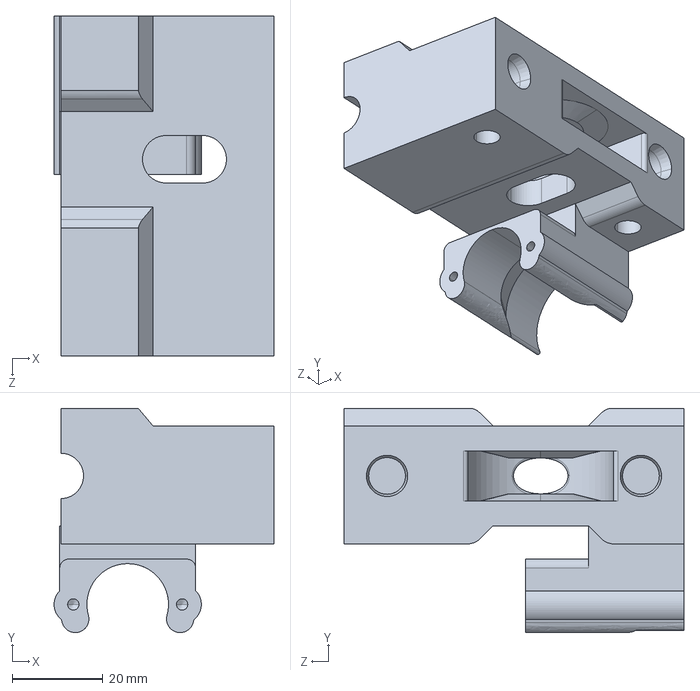
[picture p55: CAD file, 2019-01-01]
2Z X-Axis Bearing Holder - RIGHT/STEP/2Z bearing holder right body-body.STEP
48.5 x 49.4 x 75.0 mm
