Proto-Plastik/ULTIMATE/Controller Enclosure/STEP/control knob.STEP

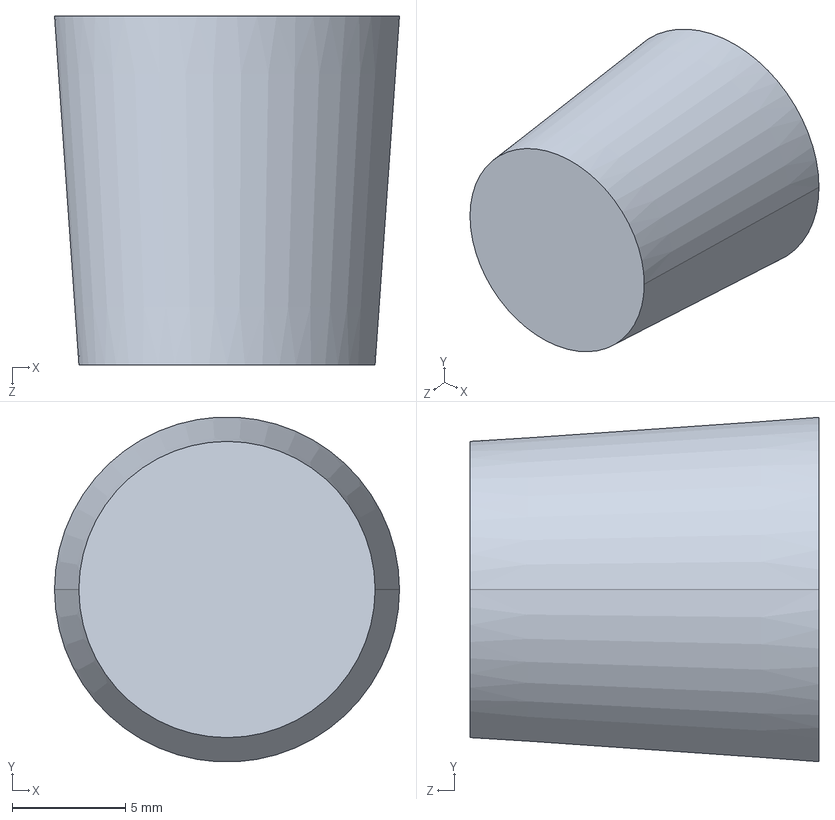
[picture p57: CAD file, 2019-01-01]
Controller Enclosure/STEP/control knob.STEP
15.2 x 15.2 x 15.4 mm
