Proto-Plastik/ULTIMATE/Filament Drive Bearing Holder/STEP/belt retainer.STEP

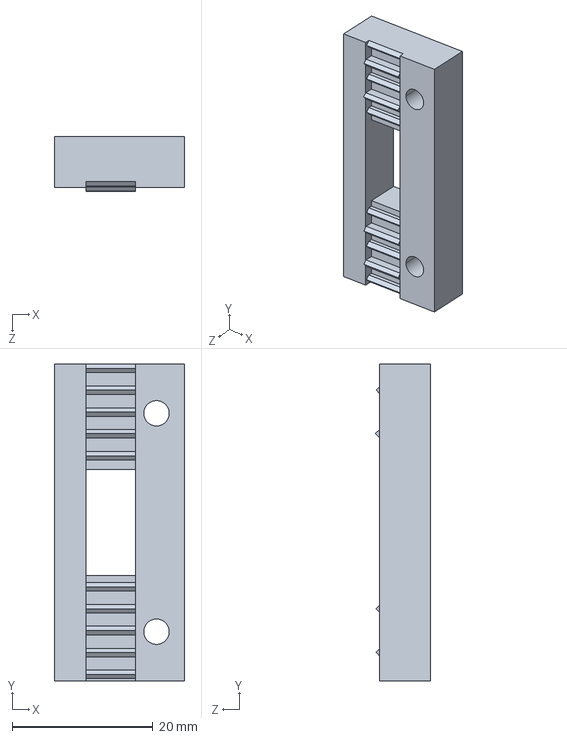
[picture p58: CAD file, 2019-01-01]
Filament Drive Bearing Holder/STEP/belt retainer.STEP
18.5 x 45.0 x 7.87 mm
