Proto-Plastik/ULTIMATE/Filament Spool Holder/STEP/Proto-Plastik filament spool holder spindle pin.STEP

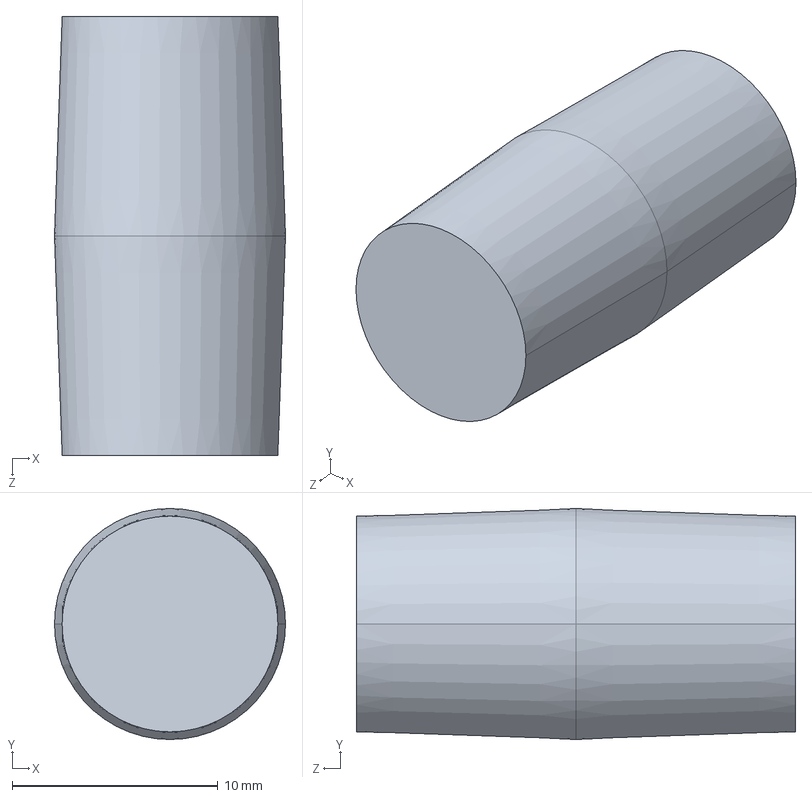
[picture p60: CAD file, 2019-01-01]
Filament Spool Holder/STEP/Proto-Plastik filament spool holder spindle pin.STEP
11.2 x 11.2 x 21.3 mm
