Proto-Plastik/ULTIMATE/Motor Houisng YZ-Axis/STEP/motor housing RIGHT-body.STEP

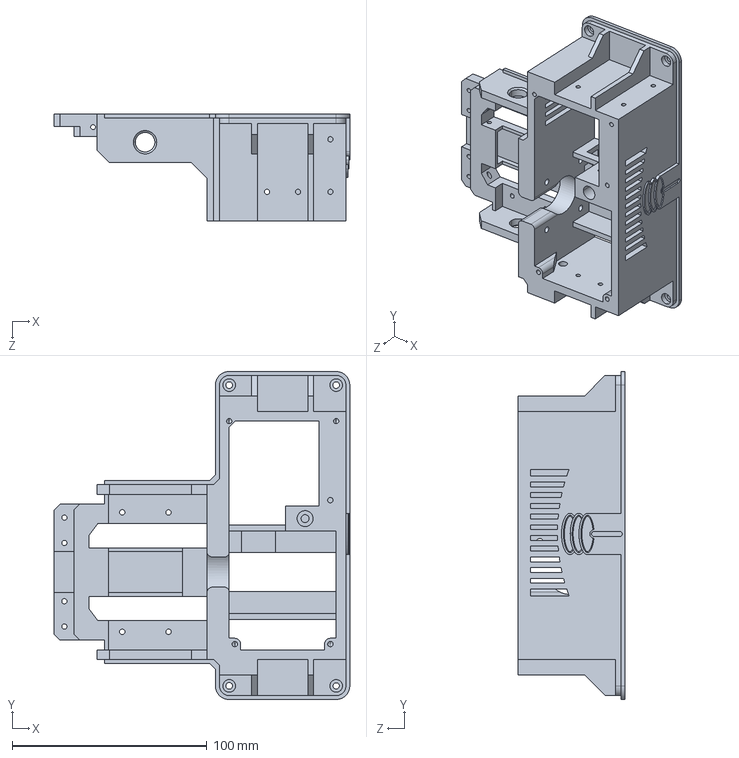
[picture p61: CAD file, 2019-01-01]
Motor Houisng YZ-Axis/STEP/motor housing RIGHT-body.STEP
152.0 x 168.6 x 55.0 mm
