Proto-Plastik/ULTIMATE/Power Supply Mount/STEP/power supply cover (no fuse 12v switch).STEP

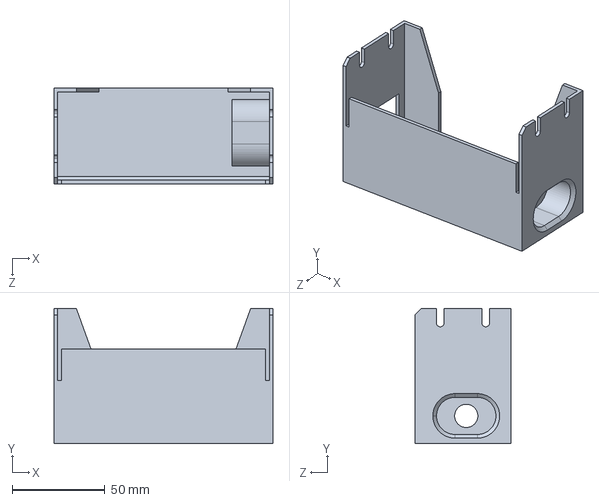
[picture p62: CAD file, 2019-01-01]
Power Supply Mount/STEP/power supply cover (no fuse 12v switch).STEP
118.0 x 73.0 x 51.5 mm
