Proto-Plastik/ULTIMATE/2Z X-Axis Bearing Holder - LEFT/STEP/ACME threaded retainer.STEP

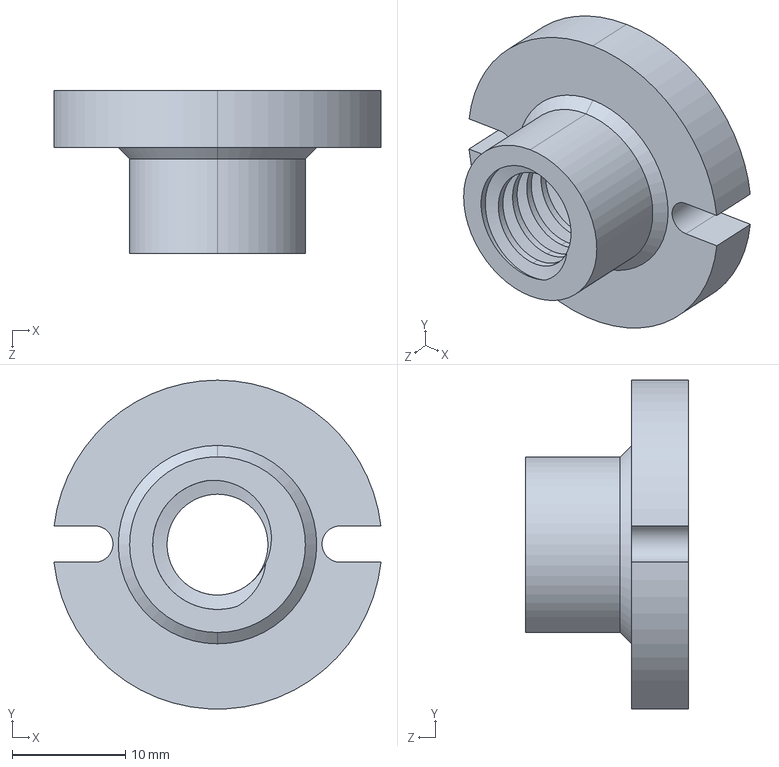
[picture p64: CAD file, 2018-01-10]
2Z X-Axis Bearing Holder - LEFT/STEP/ACME threaded retainer.STEP
28.8 x 29.0 x 14.3 mm
