Proto-Plastik/ULTIMATE/2Z X-Axis Bearing Holder - RIGHT/STEP/2Z bearing holder right body-tightener - revised.STEP

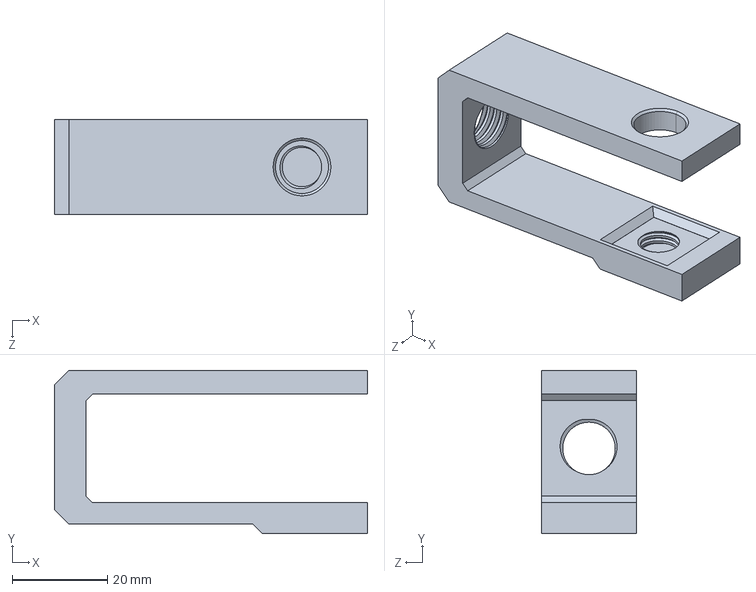
[picture p65: CAD file, 2019-01-01]
2Z X-Axis Bearing Holder - RIGHT/STEP/2Z bearing holder right body-tightener - revised.STEP
65.6 x 34.3 x 20.0 mm
