Proto-Plastik/ULTIMATE/Filament Drive/STEP/filament guide access.STEP

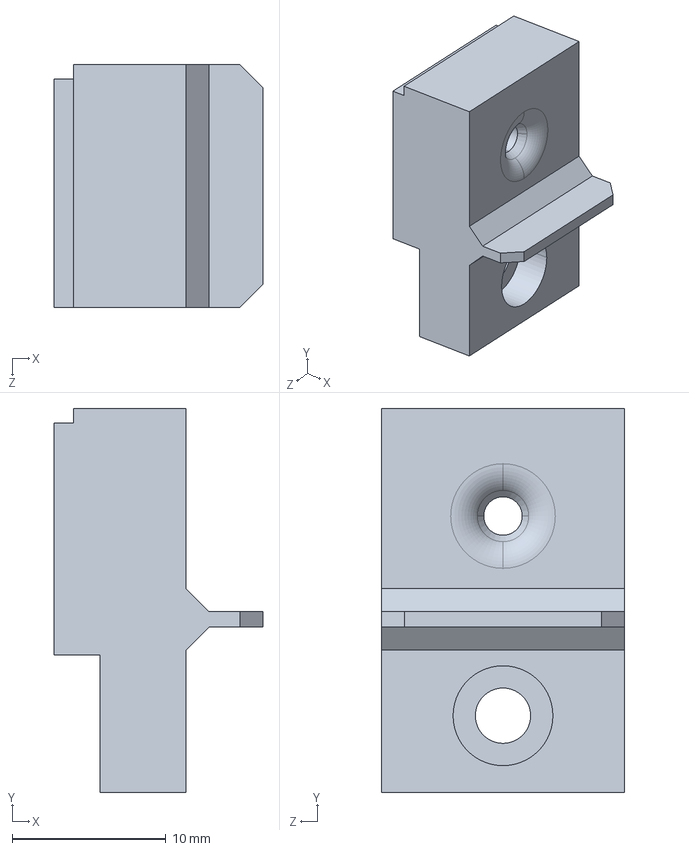
[picture p67: CAD file, 2019-01-01]
Filament Drive/STEP/filament guide access.STEP
13.6 x 25.0 x 15.8 mm
