Proto-Plastik/ULTIMATE/Power Supply Mount/STEP/power supply adapter (ULTIMATE).STEP

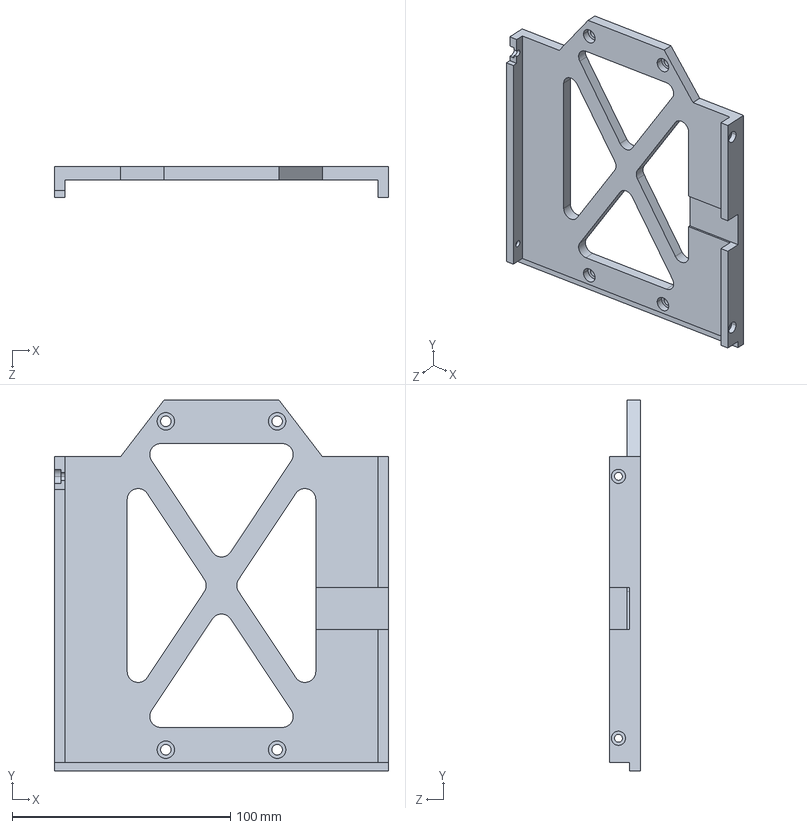
[picture p68: CAD file, 2019-01-01]
Power Supply Mount/STEP/power supply adapter (ULTIMATE).STEP
153.2 x 170.0 x 14.0 mm
