Proto-Plastik/ULTIMATE/Truss Handle/STEP/truss handle bottom.STEP

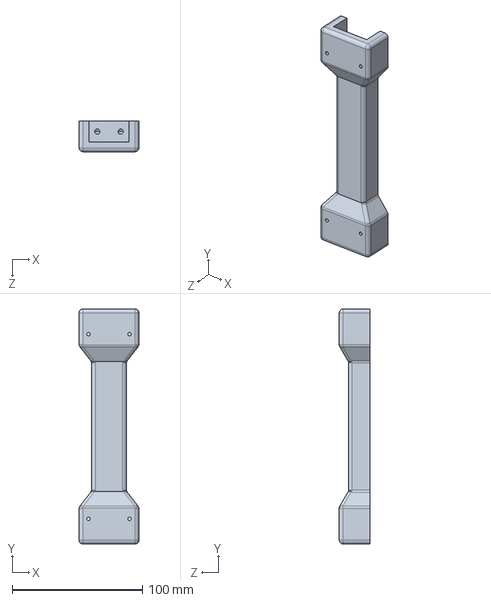
[picture p69: CAD file, 2019-01-01]
Truss Handle/STEP/truss handle bottom.STEP
46.0 x 180.5 x 23.5 mm
