Proto-Plastik/ULTIMATE/Vertical Truss-left with Electronics Enclosure/STEP/top cross brace.STEP

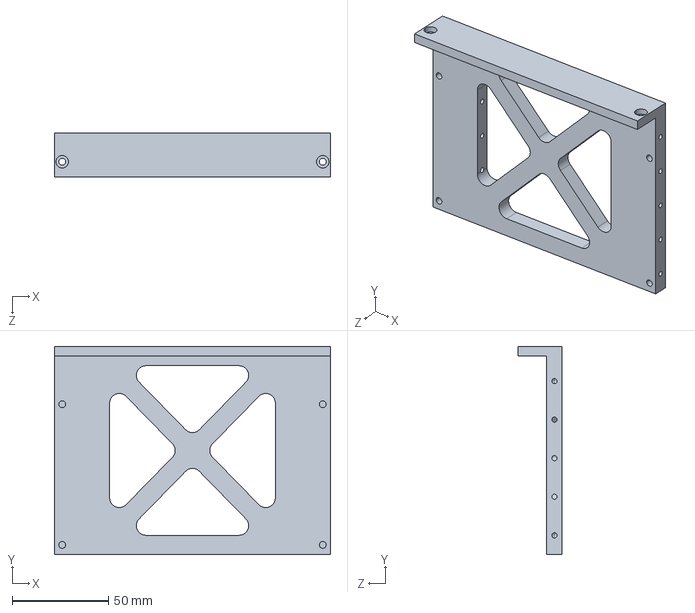
[picture p70: CAD file, 2019-01-01]
Vertical Truss-left with Electronics Enclosure/STEP/top cross brace.STEP
143.2 x 108.0 x 23.0 mm
