Proto-Plastik/ULTIMATE/2Z X-Axis Bearing Holder - RIGHT/STEP/ACME threaded retainer.STEP

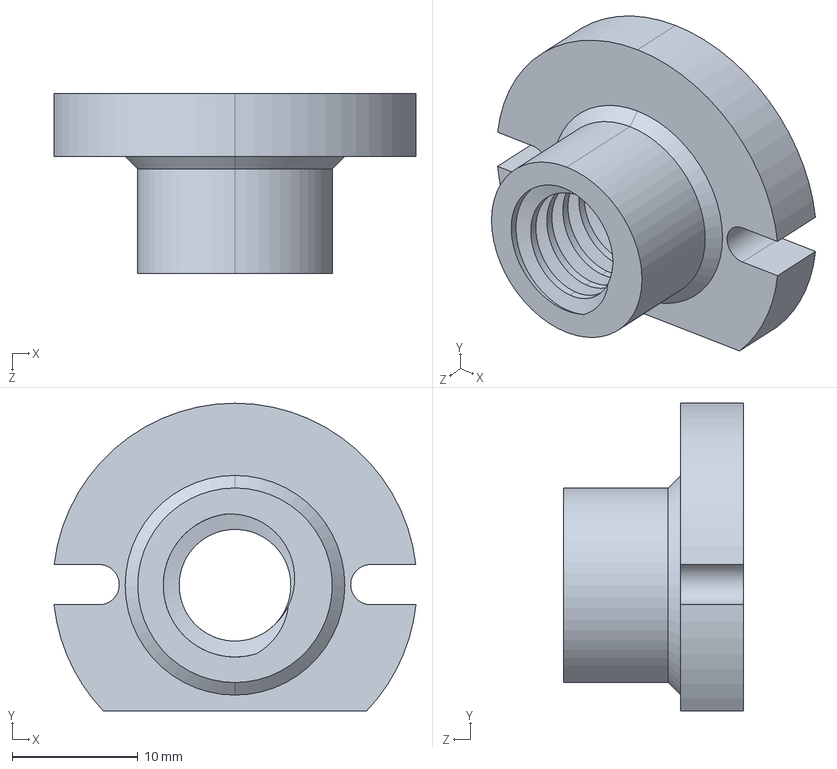
[picture p71: CAD file, 2018-01-10]
2Z X-Axis Bearing Holder - RIGHT/STEP/ACME threaded retainer.STEP
28.8 x 24.5 x 14.3 mm
