Proto-Plastik/ULTIMATE/Filament Drive/STEP/hot end mount-body.STEP

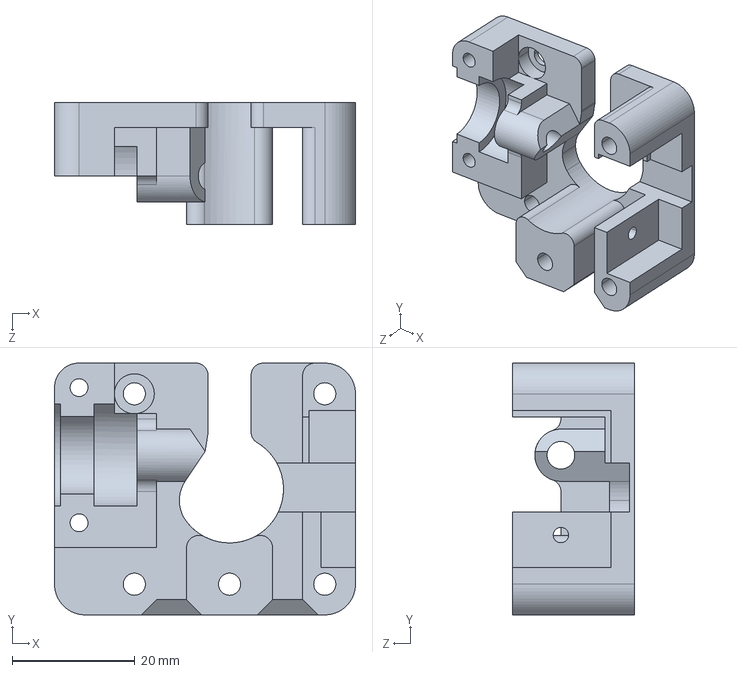
[picture p73: CAD file, 2019-01-01]
Filament Drive/STEP/hot end mount-body.STEP
49.0 x 41.0 x 19.9 mm
