Proto-Plastik/ULTIMATE/Filament Spool Holder/STEP/filament spool holder spindle-hub.STEP

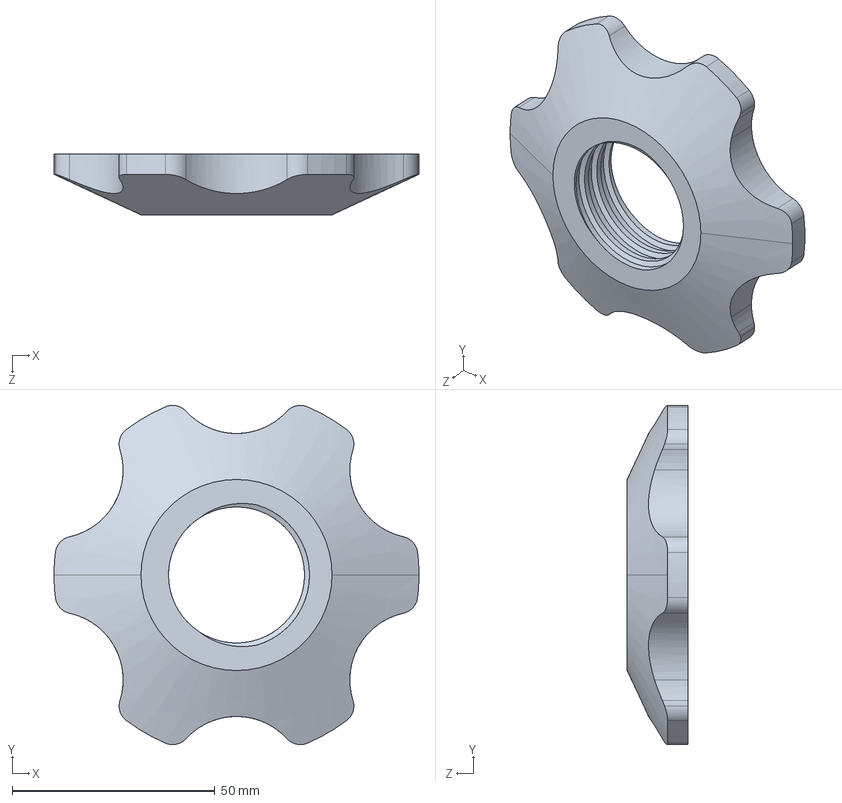
[picture p74: CAD file, 2019-01-01]
Filament Spool Holder/STEP/filament spool holder spindle-hub.STEP
90.0 x 83.6 x 15.0 mm
