Proto-Plastik/ULTIMATE/Truss Handle/STEP/truss center (2Z).STEP

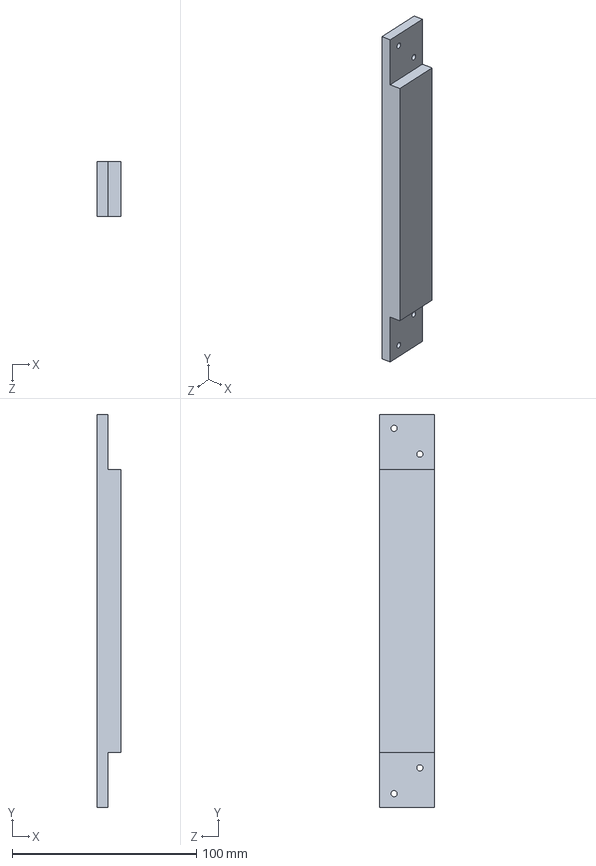
[picture p75: CAD file, 2019-01-01]
Truss Handle/STEP/truss center (2Z).STEP
13.0 x 213.3 x 30.0 mm
