Proto-Plastik/ULTIMATE/Vertical Truss-left with Electronics Enclosure/STEP/vertical truss -left rear upper.STEP

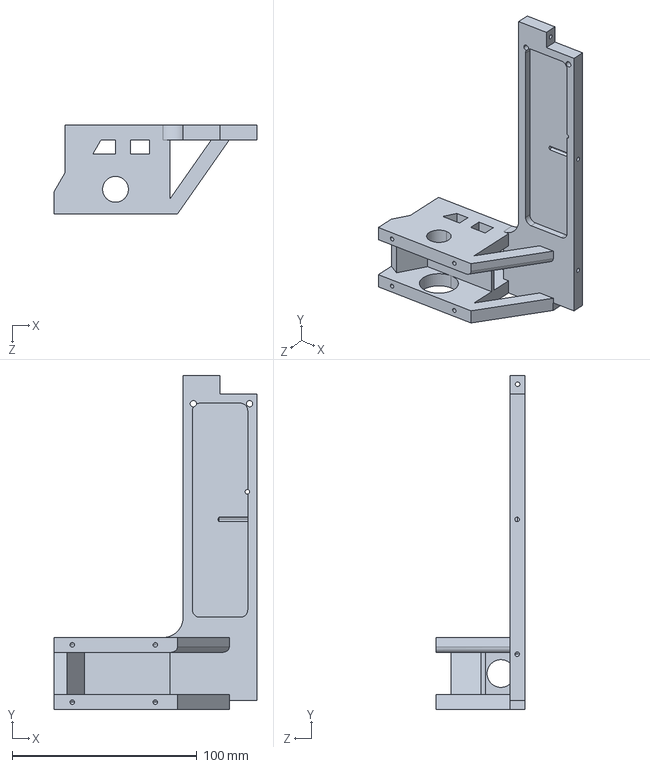
[picture p76: CAD file, 2019-01-01]
Vertical Truss-left with Electronics Enclosure/STEP/vertical truss -left rear upper.STEP
110.0 x 181.0 x 48.1 mm
