Proto-Plastik/ULTIMATE/Filament Spool Holder/STEP/filament spool holder spindle-shaft.STEP

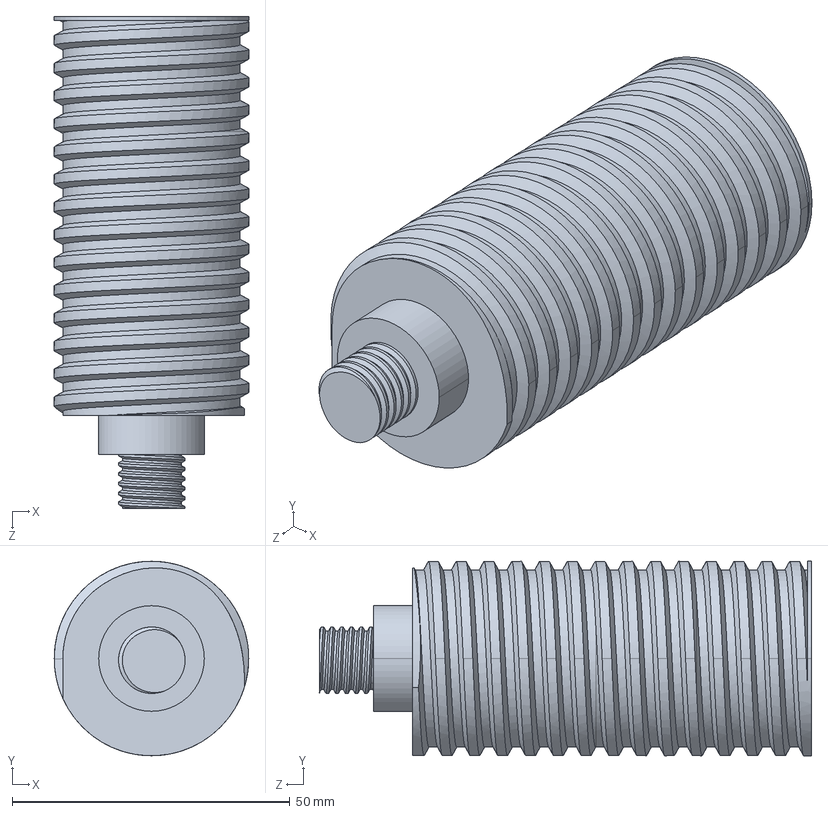
[picture p77: CAD file, 2018-03-20]
Filament Spool Holder/STEP/filament spool holder spindle-shaft.STEP
35.0 x 35.0 x 88.5 mm
