Proto-Plastik/ULTIMATE/Filament Spool Holder/STEP/filament spool holder spindle-shaft 1Z.STEP

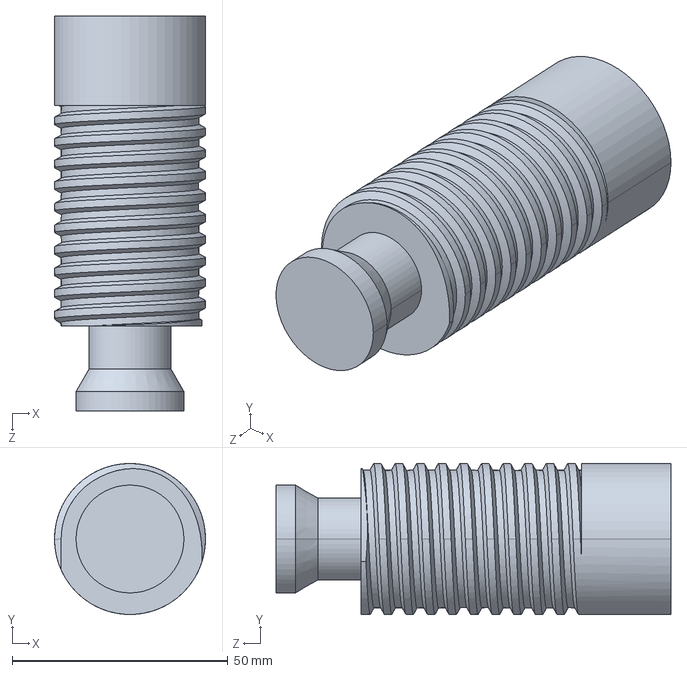
[picture p78: CAD file, 2018-01-07]
Filament Spool Holder/STEP/filament spool holder spindle-shaft 1Z.STEP
35.0 x 35.0 x 91.5 mm
