Proto-Plastik/ULTIMATE/(list of files, cad)

Other CAD files:
Filament Drive/STEP/stepper (hardware)-dampener.STEP
A5 Bed/STEP/build platform-clip retainer.STEP
Name Bar/STEP/Name Bar-end-OH.STEP
Spool Mount Truss/STEP/spool holder bracket - rear (default).STEP
A5 Bed Build Platform/STEP/build platform-NE.STEP
A5 Frame Chassis Center/STEP/chassis.STEP
Filament Drive Cooling Fan/STEP/fan nozzle.STEP
Filament Spool Holder/STEP/filament spool holder spindle-shaft 2Z OH (ULTIMATE).STEP
Motor Houisng YZ-Axis/STEP/motor housing RIGHT-cover.STEP
Motor Housing Z-Axis/STEP/stepper (hardware)-dampener.STEP
Spool Mount Truss/STEP/spool holder bracket - rear.STEP
2Z X-Axis Bearing Holder - LEFT/STEP/2Z bearing holder left body.STEP
A5 Bed Chassis/STEP/bed chassis-shaft retainer (Mirror290mm4).STEP
Filament Drive Tightener/STEP/tightening knob.STEP
Motor Housing Z-Axis/STEP/rigid coupler.STEP
Spool Mount Truss/STEP/spool holder bracket - front.STEP
Truss Handle/STEP/truss end (OH).STEP
Vertical Truss-right with Spool Mount/STEP/vertical truss-right front lower.STEP
A5 Bed Chassis/STEP/bed chassis-shaft retainer (Mirror290mm3).STEP
Filament Drive Bearing Holder/STEP/bearing lower retainer.STEP
Filament Spool Holder/STEP/filament spool holder spindle-retainer.STEP
Motor Houisng YZ-Axis/STEP/stepper (hardware)-dampener.STEP
Motor Housing Z-Axis/STEP/mounting foot TPE.STEP
Vertical Truss-right with Spool Mount/STEP/vertical truss-right front upper.STEP
Filament Drive Bearing Holder/STEP/bearing upper retainer.STEP
Power Supply Mount/STEP/power supply cover.STEP
Vertical Truss-right with Spool Mount/STEP/top cross brace.STEP
A5 Bed Chassis/STEP/bed chassis-spreader.STEP
Filament Drive Bearing Holder/STEP/bearing holder body.STEP
Filament Spool Holder/STEP/filament spool holder spindle-shaft 2Z OH.STEP
Power Supply Mount/STEP/power supply adapter.STEP
Truss Handle/STEP/truss end.STEP
Power Supply Mount/STEP/lower cross brace.STEP
Truss Handle/STEP/filament guide.STEP
Truss Handle/STEP/truss center.STEP
2Z X-Axis Bearing Holder - LEFT/2Z bearing holder left body (LM8LUU).STL
2Z X-Axis Bearing Holder - LEFT/2Z bearing holder left body.STL
2Z X-Axis Bearing Holder - LEFT/2Z bearing holder left cover.STL
2Z X-Axis Bearing Holder - LEFT/ACME threaded retainer.STL
2Z X-Axis Bearing Holder - LEFT/stepper (hardware)-dampener.STL
2Z X-Axis Bearing Holder - RIGHT/2Z bearing holder right body-body.STL
2Z X-Axis Bearing Holder - RIGHT/2Z bearing holder right body-tightener - revised.STL
2Z X-Axis Bearing Holder - RIGHT/2Z bearing holder right cover.STL
2Z X-Axis Bearing Holder - RIGHT/ACME threaded retainer.STL
2Z X-Axis Bearing Holder - RIGHT/STEP/lock nut.STEP
2Z X-Axis Bearing Holder - RIGHT/lock nut.STL
2Z X-Axis Bearing Holder - RIGHT/tightening knob.STL
A5 Bed Build Platform/build platform-NE.STL
A5 Bed Build Platform/build platform-NW.STL
A5 Bed Build Platform/build platform-SE.STL
A5 Bed Build Platform/build platform-SW.STL
A5 Bed Build Platform/spring cup.STL
A5 Bed Chassis/bed chassis-belt retainer.STL
A5 Bed Chassis/bed chassis-end stop.STL
A5 Bed Chassis/bed chassis-shaft retainer (Mirror290mm3).STL
A5 Bed Chassis/bed chassis-shaft retainer (Mirror290mm4).STL
A5 Bed Chassis/bed chassis-shaft retainer.STL
A5 Bed Chassis/bed chassis-spreader-OH.STL
A5 Bed Chassis/bed chassis-spreader.STL
A5 Bed/build platform-clip retainer-OH.STL
A5 Bed/build platform-clip retainer.STL
A5 Frame Chassis Center/5mm ID x 8mm OD x 6mm Flanged.STL
A5 Frame Chassis Center/chassis (300mm).STL
A5 Frame Chassis Center/chassis.STL
Controller Enclosure/control knob.STL
Controller Enclosure/display mount-body.STL
Controller Enclosure/display mount-cover.STL
Controller Enclosure/display mount-rear cover.STL
Electronics Base/electronics base.STL
Filament Drive Bearing Holder/bearing holder body (LM8LUU).STL
Filament Drive Bearing Holder/bearing holder body.STL
Filament Drive Bearing Holder/bearing lower retainer (LM8LUU).STL
Filament Drive Bearing Holder/bearing lower retainer.STL
Filament Drive Bearing Holder/bearing upper retainer (LM8LUU).STL
Filament Drive Bearing Holder/bearing upper retainer.STL
Filament Drive Bearing Holder/belt retainer.STL
Filament Drive Bed Leveling/Filament Drive BL Touch Mount.STL
Filament Drive Cooling Fan/fan nozzle (BL2).STL
Filament Drive Cooling Fan/fan nozzle.STL
Filament Drive Cooling Fan/nozzle bracket.STL
Filament Drive Tightener/STEP/lock nut.STEP
Filament Drive Tightener/lock nut.STL
Filament Drive Tightener/tensioner.STL
Filament Drive Tightener/tightening knob (filament drive).STL
Filament Drive Tightener/tightening knob.STL
Filament Drive/filament guide access.STL
Filament Drive/hot end cover.STL
Filament Drive/hot end mount-body.STL
Filament Drive/hot end retainer.STL
Filament Drive/motor mount.STL
Filament Drive/stepper (hardware)-dampener.STL
Filament Spool Holder/Proto-Plastik filament spool holder spindle pin.STL
Filament Spool Holder/filament spool holder spindle-hub.STL
Filament Spool Holder/filament spool holder spindle-retainer (OH).STL
Filament Spool Holder/filament spool holder spindle-retainer.STL
Filament Spool Holder/filament spool holder spindle-shaft 1Z.STL
Filament Spool Holder/filament spool holder spindle-shaft 2Z OH (OH).STL
Filament Spool Holder/filament spool holder spindle-shaft 2Z OH (ULTIMATE).STL
Filament Spool Holder/filament spool holder spindle-shaft 2Z OH.STL
Filament Spool Holder/filament spool holder spindle-shaft.STL
Motor Houisng YZ-Axis/motor housing RIGHT-body.STL
Motor Houisng YZ-Axis/motor housing RIGHT-cover.STL
Motor Houisng YZ-Axis/mounting foot TPE.STL
Motor Houisng YZ-Axis/rigid coupler.STL
Motor Houisng YZ-Axis/stepper (hardware)-dampener.STL
Motor Housing Z-Axis/motor housing LEFT-Body.STL
Motor Housing Z-Axis/motor housing LEFT-Cover.STL
Motor Housing Z-Axis/mounting foot TPE.STL
Motor Housing Z-Axis/rigid coupler.STL
Motor Housing Z-Axis/stepper (hardware)-dampener.STL
Name Bar/Name Bar-end-OH.STL
Name Bar/Name Bar-end.STL
PI Camera Housing/PI_CAMERA-body.STL
PI Camera Housing/PI_CAMERA-cover.STL
Power Supply Mount/latch.STL
Power Supply Mount/lower cross brace (ULTIMATE).STL
Power Supply Mount/lower cross brace-cover hinge.STL
Power Supply Mount/lower cross brace.STL
Power Supply Mount/power supply adapter (ULTIMATE).STL
Power Supply Mount/power supply adapter.STL
Power Supply Mount/power supply cover (no fuse 12v switch).STL
Power Supply Mount/power supply cover.STL
Spool Mount Truss/spool holder bracket - front (Spool Holder).STL
Spool Mount Truss/spool holder bracket - front.STL
Spool Mount Truss/spool holder bracket - rear (default).STL
Spool Mount Truss/spool holder bracket - rear.STL
Truss Handle/filament guide (single).STL
Truss Handle/filament guide.STL
Truss Handle/truss center (2Z).STL
Truss Handle/truss center.STL
Truss Handle/truss end (OH).STL
Truss Handle/truss end (ULTIMATE).STL
Truss Handle/truss end.STL
Truss Handle/truss handle bottom.STL
Truss Handle/truss handle top.STL
Vertical Truss-left with Electronics Enclosure/lower front-hinge.STL
Vertical Truss-left with Electronics Enclosure/top cross brace.STL
Vertical Truss-left with Electronics Enclosure/vertical truss -left rear upper.STL
Vertical Truss-left with Electronics Enclosure/vertical truss-left front lower.STL
Vertical Truss-left with Electronics Enclosure/vertical truss-left front upper.STL
Vertical Truss-left with Electronics Enclosure/vertical truss-left rear lower.STL
Vertical Truss-right with Spool Mount/top cross brace (with Filament Guide).STL
Vertical Truss-right with Spool Mount/top cross brace.STL
Vertical Truss-right with Spool Mount/vertical truss -right rear lower.STL
Vertical Truss-right with Spool Mount/vertical truss-right front lower.STL
Vertical Truss-right with Spool Mount/vertical truss-right front upper.STL
Vertical Truss-right with Spool Mount/vertical truss-right rear upper.STL
Y-Axis Bearing Cover and Tray/Cover and Tray.STL
y-axis tightener/y-axis tightener-knob.STL
