Proto-Plastik/ULTIMATE/(threads)

Thread 1 (2018-05-18):

Not all files oriented properly

Proto-Plastik, 2018-05-18:
Some of the STL files may not be oriented correctly for direct print. I am working to alleviate that, but in the meantime please be aware you may have to manually arrange these files in your print processing application.
