Proto-Plastik/ULTIMATE/(commit log)

2017-12-20 Initial upload.
    [2Z bearing holder left body.STL, 2Z bearing holder left cover.STL, 2Z bearing holder right body-tightener - revised.STL, 2Z bearing holder right cover.STL, 5mm ID x 8mm OD x 6mm Flanged.STL, ACME threaded retainer.STL, Cover and Tray.STL, Filament Drive BL Touch Mount.STL]
2017-12-20 Added Marlin firmware for use on the MKS Base 1.5 for the ULTIMATE 3D Printer
    [Configuration.h, Configuration_adv.h]
2017-12-20 Added preliminary assembly drawings
2017-12-21 - updated documentation - split the 2Z X-Ais Bearing Holder
    [2Z bearing holder left body.STL, 2Z bearing holder left cover.STL, 2Z bearing holder right body-body.STL, 2Z bearing holder right body-tightener - revised.STL, 2Z bearing holder right cover.STL, 5mm ID x 8mm OD x 6mm Flanged.STL, ACME threaded retainer.STL, Filament Drive BL Touch Mount.STL]
2017-12-21 updated the hot end retainer
    [hot end retainer.STL]
2017-12-22 updated the ACME threaded retainer for the LEFT X-Axis bearing holder
    [ACME threaded retainer.STL]
2017-12-31 December EOM build
    [2Z bearing holder left body.STL, 2Z bearing holder left cover.STL, 2Z bearing holder right body-body.STL, 2Z bearing holder right body-tightener - revised.STL, 2Z bearing holder right cover.STL, 5mm ID x 8mm OD x 6mm Flanged.STL, ACME threaded retainer.STL, Filament Drive BL Touch Mount.STL]
2017-12-31 Added SAT files to source
    [2Z bearing holder left body.STL, 2Z bearing holder right body-body.STL, Cover and Tray.STL, build platform-NW.STL, fan nozzle.STL, filament guide access.STL, filament guide.STL, hot end cover.STL]
2018-01-05 fixed the name bar. Fixed the top cross plates on the gantry.
    [2Z bearing holder left body.STL, 2Z bearing holder left cover.STL, 2Z bearing holder right body-body.STL, Cover and Tray.STL, Name Bar-end-OH.STL, Name Bar-end.STL, bearing upper retainer.STL, build platform-NW.STL]
2018-01-06 Corrected the ACME threaded retainer for the RIGHT X-Axis bearing holder
    [ACME threaded retainer.STL]
2018-01-07 Replaced ACIS (SAT) files with correct set of STEP files
    [2Z bearing holder left body.STEP, 2Z bearing holder left body.STL, 2Z bearing holder left cover.STEP, 2Z bearing holder right body-body.STEP, 2Z bearing holder right body-body.STL, 2Z bearing holder right body-tightener - revised.STEP, 2Z bearing holder right body-tightener - revised.STL, 2Z bearing holder right cover.STEP]
2018-01-10 Fixed a problem with part configuration
    [2Z bearing holder left body.STEP, 2Z bearing holder left cover.STEP, 2Z bearing holder right body-body.STEP, 2Z bearing holder right body-tightener - revised.STEP, 2Z bearing holder right cover.STEP, 5mm ID x 8mm OD x 6mm Flanged.STEP, ACME threaded retainer.STEP, ACME threaded retainer.STL]
2018-02-09 Febuary Push. Modified bed to allow for better wire routing of the heated bed.
    [2Z bearing holder left body.STEP, 2Z bearing holder left body.STL, 2Z bearing holder left cover.STEP, 2Z bearing holder right body-body.STEP, 2Z bearing holder right body-body.STL, 2Z bearing holder right body-tightener - revised.STEP, 2Z bearing holder right body-tightener - revised.STL, 2Z bearing holder right cover.STEP]
2018-02-12 Strengthened the y-axis tightener. Other minor mods
    [2Z bearing holder left body.STEP, 2Z bearing holder left body.STL, 2Z bearing holder left cover.STEP, 2Z bearing holder right body-body.STEP, 2Z bearing holder right body-body.STL, 2Z bearing holder right body-tightener - revised.STEP, 2Z bearing holder right cover.STEP, 5mm ID x 8mm OD x 6mm Flanged.STEP]
2018-02-12 Minor update. Included some missing parts (lock nut for the x-axis gantry belt tightener).
    [2Z bearing holder left body.STEP, 2Z bearing holder left body.STL, 2Z bearing holder left cover.STEP, 2Z bearing holder right body-body.STEP, 2Z bearing holder right body-body.STL, 2Z bearing holder right body-tightener - revised.STEP, 2Z bearing holder right body-tightener - revised.STL, 2Z bearing holder right cover.STEP]
2018-02-28 Monthly Build. Small modifications to the electronics base. No including the camera mount (For Ultimate)
    [2Z bearing holder left body.STEP, 2Z bearing holder left body.STL, 2Z bearing holder left cover.STEP, 2Z bearing holder right body-body.STEP, 2Z bearing holder right body-body.STL, 2Z bearing holder right body-tightener - revised.STEP, 2Z bearing holder right body-tightener - revised.STL, 2Z bearing holder right cover.STEP]
2018-03-09 Updated the filament drive cover
    [2Z bearing holder left body.STEP, 2Z bearing holder left cover.STEP, 2Z bearing holder right body-body.STEP, 2Z bearing holder right body-tightener - revised.STEP, 2Z bearing holder right cover.STEP, 5mm ID x 8mm OD x 6mm Flanged.STEP, Cover and Tray.STEP, Filament Drive BL Touch Mount.STEP]
2018-03-14 Mid March commit. Adjusted X-Axis gantry bearing retainers. Set the y-axis tightener for the front of the bed only.
    [2Z bearing holder left body.STEP, 2Z bearing holder left body.STL, 2Z bearing holder left cover.STEP, 2Z bearing holder right body-body.STEP, 2Z bearing holder right body-body.STL, 2Z bearing holder right body-tightener - revised.STEP, 2Z bearing holder right cover.STEP, 5mm ID x 8mm OD x 6mm Flanged.STEP]
2018-03-20 Removed Firmware folders. Moved to Firmware repo.
    [2Z bearing holder left body.STEP, 2Z bearing holder left cover.STEP, 2Z bearing holder right body-body.STEP, 2Z bearing holder right body-tightener - revised.STEP, 2Z bearing holder right cover.STEP, 5mm ID x 8mm OD x 6mm Flanged.STEP, Configuration.h, Configuration_adv.h]
2018-05-17 Mid-May update. Update to x-axis bearing carrier to accomodate belt and channel for wiring to be away from the belt.
    [2Z bearing holder left body.STEP, 2Z bearing holder left body.STL, 2Z bearing holder left cover.STEP, 2Z bearing holder left cover.STL, 2Z bearing holder right body-body.STEP, 2Z bearing holder right body-body.STL, 2Z bearing holder right body-tightener - revised.STEP, 2Z bearing holder right body-tightener - revised.STL]
2018-05-18 Corrected STL orientation
    [2Z bearing holder left body.STEP, 2Z bearing holder left body.STL, 2Z bearing holder left cover.STEP, 2Z bearing holder left cover.STL, 2Z bearing holder right body-body.STEP, 2Z bearing holder right body-body.STL, 2Z bearing holder right body-tightener - revised.STEP, 2Z bearing holder right body-tightener - revised.STL]
2019-01-01 New year build
    [2Z bearing holder left body.STEP, 2Z bearing holder left body.STL, 2Z bearing holder left cover.STEP, 2Z bearing holder left cover.STL, 2Z bearing holder right body-body.STEP, 2Z bearing holder right body-body.STL, 2Z bearing holder right body-tightener - revised.STEP, 2Z bearing holder right body-tightener - revised.STL]
2019-01-01 Updated naming convention to include configuration name shown in parentheses
    [2Z bearing holder left body (LM8LUU).STEP, 2Z bearing holder left body (LM8LUU).STL, 2Z bearing holder left cover.STEP, 2Z bearing holder right body-body.STEP, 2Z bearing holder right body-tightener - revised.STEP, 2Z bearing holder right cover.STEP, 5mm ID x 8mm OD x 6mm Flanged.STEP, Cover and Tray.STEP]
